Informaticore/SuperPower/SuperPower-uC/components/BATTERY_CELL_HOLDER_18650_SMT_1042/keystone-PN1042.STEP

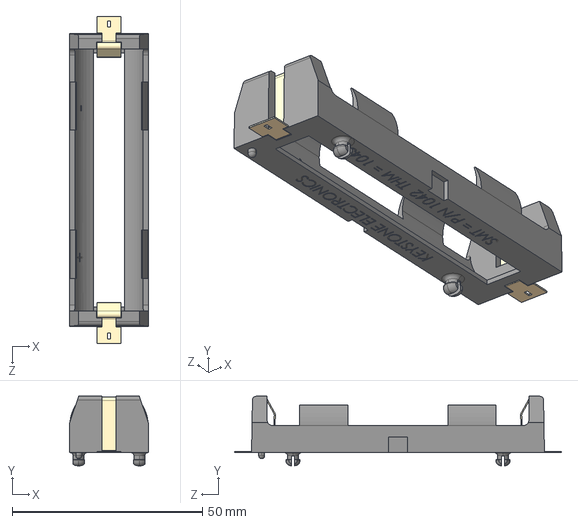
[picture p1: CAD file, 2020-12-24]
SuperPower-uC/components/BATTERY_CELL_HOLDER_18650_SMT_1042/keystone-PN1042.STEP
20.7 x 18.3 x 86.0 mm
