Informaticore/SuperPower/SuperPower-uC/components/JST_ZH_S2B_THRU/S2B-ZR.STEP

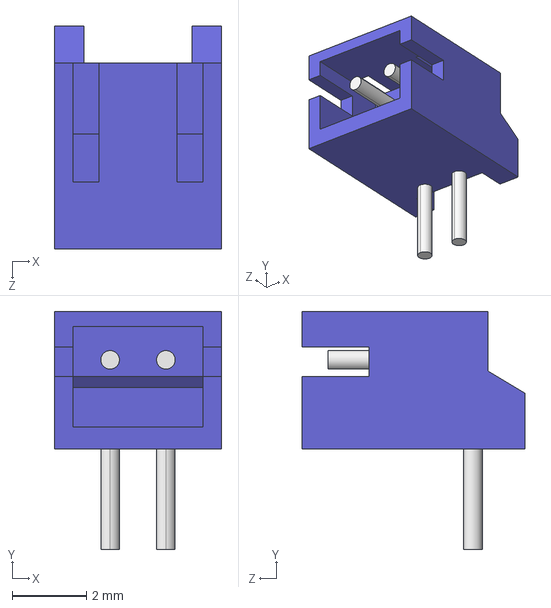
[picture p2: CAD file, 2020-12-23]
SuperPower-uC/components/JST_ZH_S2B_THRU/S2B-ZR.STEP
4.50 x 6.40 x 6.00 mm
