Informaticore/SuperPower/SuperPower-uC/components/RV-3028-C7/RV-3028-C7_MWNN.step

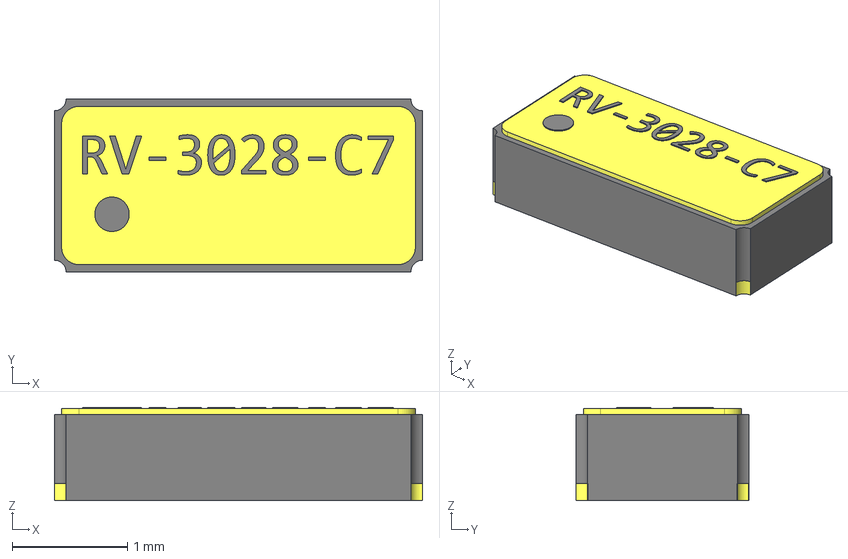
[picture p3: CAD file, 2020-12-26]
SuperPower-uC/components/RV-3028-C7/RV-3028-C7_MWNN.step
3.20 x 1.50 x 0.81 mm
Gold_Cover
Ext_pin_1
Ext_pins_org
Ext_pins_clone
Ext_pins_clone_2
Inner_pin_org
Inner_pin_clone_180deg
Inner_pin_clone_0_9mm
Inner_pin_clone_0_95mm
