Informaticore/SuperPower/SuperPower-uC/original/3D_Box/3D_Box_save_07.FCStd

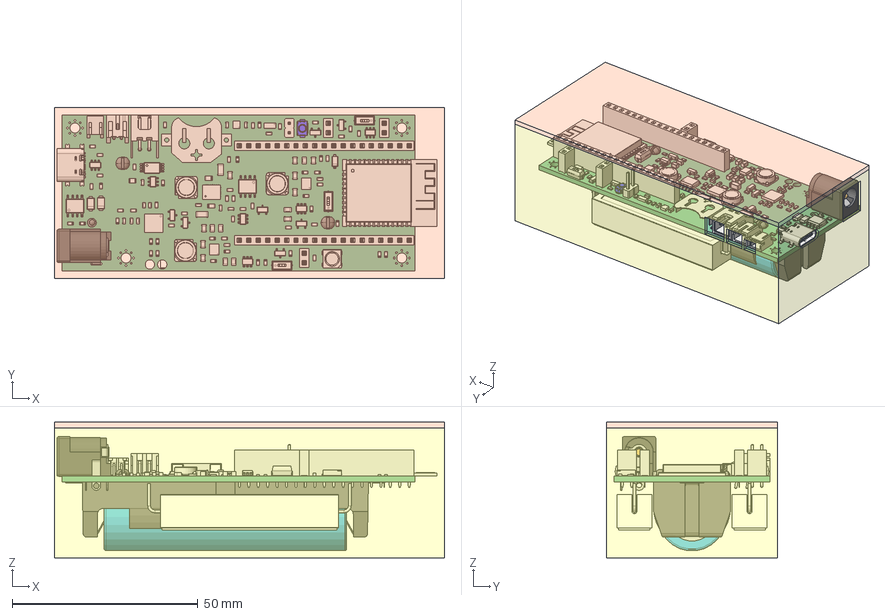
[picture p4: CAD file, 2020-12-30]
SuperPower-uC/original/3D_Box/3D_Box_save_07.FCStd
105.0 x 46.0 x 36.5 mm
Body_cover
enveloppe001
Rondelle_+
Pin
Pin_clone
Mark
Mark_Line2
Pin001
Pin_clone001
Mark001
Mark_Line003
Pcb_bade001
C13_C_0603_1608Metric_5FE1E67D
Q13_SOT_23_6_5FE1FFE7
C13_C_0603_1608Metric_5FE1E67D001
C13_C_0603_1608Metric_5FE1E67D002
R28_R_0603_1608Metric_5FE1E7A0
Q1_TSSOP_8_44x3mm_P065mm_5FE238C001
J6_PinHeader_1x02_P254mm_Vertical_5FE1EB83
U8_WSON_6_1EP_2x2mm_P065mm_EP1x16mm_5FE68943
U5_RV-4162-C7_5FE68809
SW1_SKRKAE_5FE20513
U2_USB4110-GF-A_5FE2434D
R28_R_0603_1608Metric_5FE1E7A001
R28_R_0603_1608Metric_5FE1E7A002
C13_C_0603_1608Metric_5FE1E67D003
Q13_SOT_23_6_5FE1FFE008
R1_R_0805_2012Metric_5FE21CBB008
C7_C_1206_3216Metric_5FE083F012
C13_C_0603_1608Metric_5FE1E67D004
C13_C_0603_1608Metric_5FE1E67D005
R28_R_0603_1608Metric_5FE1E7A003
R28_R_0603_1608Metric_5FE1E7A004
R28_R_0603_1608Metric_5FE1E7A005
R28_R_0603_1608Metric_5FE1E7A006
R28_R_0603_1608Metric_5FE1E7A007
Q9_SOT_23_5FE1FFAA020
Q9_SOT_23_5FE1FFAA021
C13_C_0603_1608Metric_5FE1E67D006
C13_C_0603_1608Metric_5FE1E67D007
D3_LED_SK6812_PLCC4_50x50mm_P32mm_5FE1FD084
R28_R_0603_1608Metric_5FE1E7A008
D4_D_SOD_123_5FE1DF018
C13_C_0603_1608Metric_5FE1E67D008
D1_D_PowerDI_123_5FE332B3
J5_JST_S2B_XH_A_5FE092EF001
Q9_SOT_23_5FE1FFAA022
Q9_SOT_23_5FE1FFAA023
Q9_SOT_23_5FE1FFAA024
R1_R_0805_2012Metric_5FE21CBB009
R1_R_0805_2012Metric_5FE21CBB010
R28_R_0603_1608Metric_5FE1E7A009
R28_R_0603_1608Metric_5FE1E7A010
U4_QFN_28_1EP_4x5mm_P05mm_EP265x365mm_5FDDAC5B001
U6_QFN-28-1EP_5x5mm_Pitch0.5mm_5FE1E4A004
U7_ESP32-WROOM-32_5FE1FEBA001
Q9_SOT_23_5FE1FFAA025
U10_RNR11_5FD85147
U10_RNR11_5FD85148
R28_R_0603_1608Metric_5FE1E7A011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
