Informaticore/SuperPower/SuperPower-uC/original/3D_Box/3D_Box_save_05.FCStd

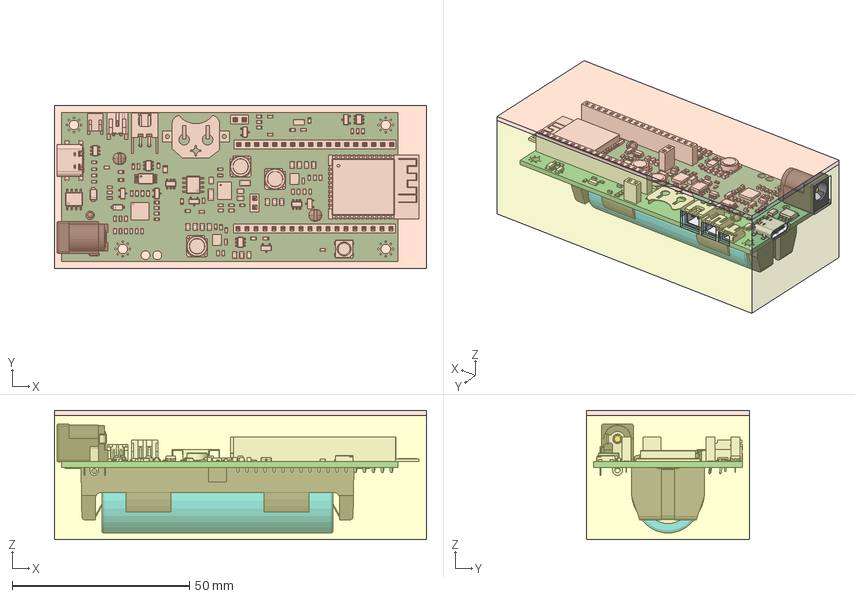
[picture p6: CAD file, 2020-12-24]
SuperPower-uC/original/3D_Box/3D_Box_save_05.FCStd
105.0 x 46.0 x 36.5 mm
Body_cover
enveloppe001
Rondelle_+
Pcb_bade
U2_USB4110-GF-A_5FE2434D001
R2_R_0603_1608Metric_5FE23902
R2_R_0603_1608Metric_5FE24000
Q1_TSSOP_8_44x3mm_P065mm_5FE238C0
C1_C_0603_1608Metric_5FE23887
U1_SOT_23_6_5FE2384D
R1_R_0805_2012Metric_5FE21CBB
C7_C_1206_3216Metric_5FE083F7
C1_C_0603_1608Metric_5FE23919
C1_C_0603_1608Metric_5FE23920
R2_R_0603_1608Metric_5FE24001
R2_R_0603_1608Metric_5FE24002
R2_R_0603_1608Metric_5FE24003
R2_R_0603_1608Metric_5FE24004
R2_R_0603_1608Metric_5FE24005
U1_SOT_23_6_5FE2384D010
Q9_SOT_23_5FE1FFAA
Q9_SOT_23_5FE1FFAA014
C1_C_0603_1608Metric_5FE23921
C1_C_0603_1608Metric_5FE23922
D3_LED_SK6812_PLCC4_50x50mm_P32mm_5FE1FD83
R2_R_0603_1608Metric_5FE24006
D4_D_SOD_123_5FE1DF17
C1_C_0603_1608Metric_5FE23923
D1_D_PowerDI_123_5FE332B004
J5_JST_S2B_XH_A_5FE092EF
J8_PinSocket_1x18_P254mm_Vertical_5FE1FDD2
Q9_SOT_23_5FE1FFAA015
Q9_SOT_23_5FE1FFAA016
Q9_SOT_23_5FE1FFAA017
R1_R_0805_2012Metric_5FE21CBB006
R1_R_0805_2012Metric_5FE21CBB007
R2_R_0603_1608Metric_5FE24007
R2_R_0603_1608Metric_5FE24008
U4_QFN_28_1EP_4x5mm_P05mm_EP265x365mm_5FDDAC5B
U6_QFN-28-1EP_5x5mm_Pitch0.5mm_5FE1E4A3
U7_ESP32-WROOM-32_5FE1FEBA
Q9_SOT_23_5FE1FFAA018
U10_RNR11_5FD85142
U10_RNR11_5FD85146
U5_RV-4162-C7_5FE1E3D3
R2_R_0603_1608Metric_5FE24009
R2_R_0603_1608Metric_5FE24010
R2_R_0603_1608Metric_5FE24011
R2_R_0603_1608Metric_5FE24012
R2_R_0603_1608Metric_5FE24013
R2_R_0603_1608Metric_5FE24014
R2_R_0603_1608Metric_5FE24015
R2_R_0603_1608Metric_5FE24016
R2_R_0603_1608Metric_5FE24017
R2_R_0603_1608Metric_5FE24018
R2_R_0603_1608Metric_5FE24019
R2_R_0603_1608Metric_5FE24020
J6_PinSocket_1x02_P254mm_Vertical_5FE1EB83
C25_C_0805_2012Metric_5FE224A7
C1_C_0603_1608Metric_5FE23924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
