Informaticore/SuperPower/SuperPower-uC/original/3D_Box/3D_Box_save_04.FCStd

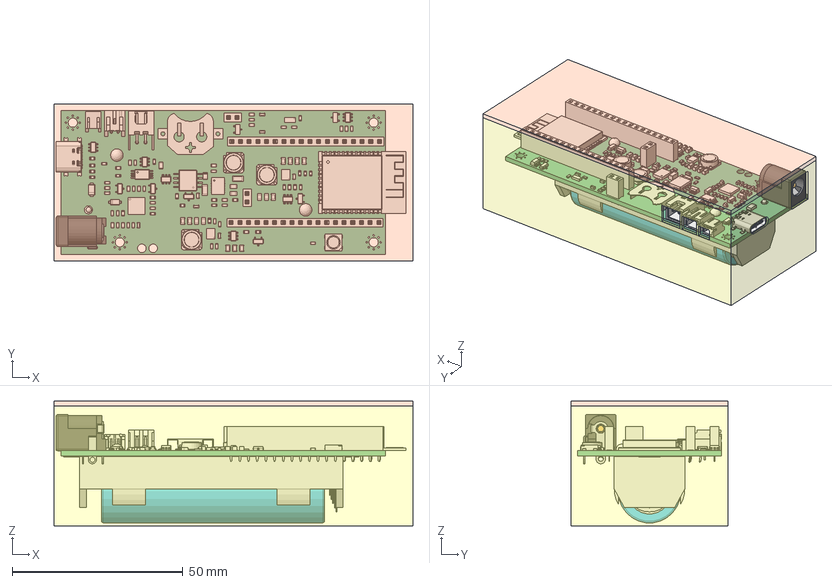
[picture p7: CAD file, 2020-12-23]
SuperPower-uC/original/3D_Box/3D_Box_save_04.FCStd
105.0 x 46.0 x 36.5 mm
Body_cover
Pcb_bade001
U2_USB4110-GF-A_5FE2434D
R2_R_0603_1608Metric_5FE23951
R2_R_0603_1608Metric_5FE23952
Q1_TSSOP_8_44x3mm_P065mm_5FE238C001
C1_C_0603_1608Metric_5FE23903
U1_SOT_23_6_5FE2384D005
R1_R_0805_2012Metric_5FE21CBB003
C7_C_1206_3216Metric_5FE083F009
C1_C_0603_1608Metric_5FE23904
C1_C_0603_1608Metric_5FE23905
R2_R_0603_1608Metric_5FE23953
R2_R_0603_1608Metric_5FE23954
R2_R_0603_1608Metric_5FE23955
R2_R_0603_1608Metric_5FE23956
R2_R_0603_1608Metric_5FE23957
U1_SOT_23_6_5FE2384D006
Q9_SOT_23_5FE1FFAA007
Q9_SOT_23_5FE1FFAA008
C1_C_0603_1608Metric_5FE23906
C1_C_0603_1608Metric_5FE23907
D3_LED_SK6812_PLCC4_50x50mm_P32mm_5FE1FD084
R2_R_0603_1608Metric_5FE23958
D4_D_SOD_123_5FE1DF018
C1_C_0603_1608Metric_5FE23908
D1_D_PowerDI_123_5FE332B3
J5_JST_S2B_XH_A_5FE092EF001
J8_PinSocket_1x18_P254mm_Vertical_5FE1FDD004
Q9_SOT_23_5FE1FFAA009
Q9_SOT_23_5FE1FFAA010
Q9_SOT_23_5FE1FFAA011
R1_R_0805_2012Metric_5FE21CBB004
R1_R_0805_2012Metric_5FE21CBB005
R2_R_0603_1608Metric_5FE23959
R2_R_0603_1608Metric_5FE23960
U4_QFN_28_1EP_4x5mm_P05mm_EP265x365mm_5FDDAC5B001
U6_QFN-28-1EP_5x5mm_Pitch0.5mm_5FE1E4A004
U7_ESP32-WROOM-32_5FE1FEBA001
Q9_SOT_23_5FE1FFAA012
U10_RNR11_5FD85144
U10_RNR11_5FD85145
U5_RV-4162-C7_5FE1E3D004
R2_R_0603_1608Metric_5FE23961
R2_R_0603_1608Metric_5FE23962
R2_R_0603_1608Metric_5FE23963
R2_R_0603_1608Metric_5FE23964
R2_R_0603_1608Metric_5FE23965
R2_R_0603_1608Metric_5FE23966
R2_R_0603_1608Metric_5FE23967
R2_R_0603_1608Metric_5FE23968
R2_R_0603_1608Metric_5FE23969
R2_R_0603_1608Metric_5FE23970
R2_R_0603_1608Metric_5FE23971
R2_R_0603_1608Metric_5FE23972
J6_PinSocket_1x02_P254mm_Vertical_5FE1EB085
C25_C_0805_2012Metric_5FE224A022
C1_C_0603_1608Metric_5FE23909
C25_C_0805_2012Metric_5FE224A023
C25_C_0805_2012Metric_5FE224A024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
