Informaticore/SuperPower/SuperPower-uC/original/3D_Box/3D_Box_save_01.FCStd

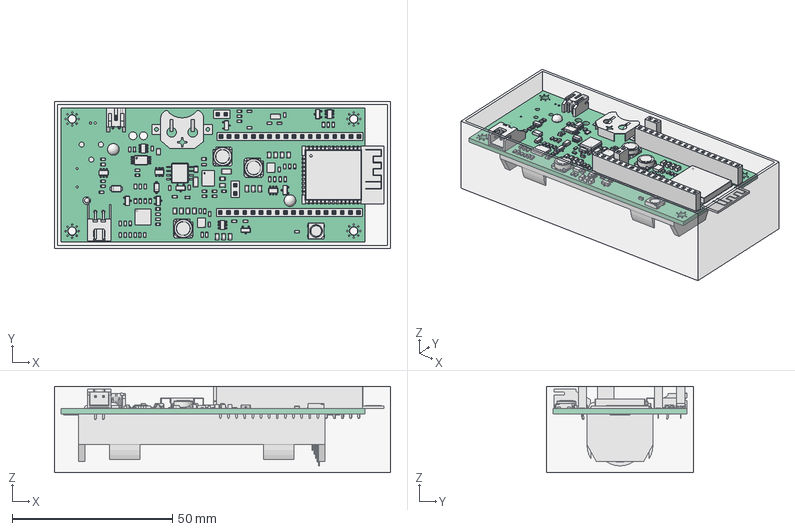
[picture p8: CAD file, 2020-12-22]
SuperPower-uC/original/3D_Box/3D_Box_save_01.FCStd
105.0 x 46.0 x 27.0 mm
Pcb_bade
R2_R_0603_1608Metric_5FE23902
R2_R_0603_1608Metric_5FE23903
Q1_TSSOP_8_44x3mm_P065mm_5FE238C0
C1_C_0603_1608Metric_5FE23887
U1_SOT_23_6_5FE2384D
R1_R_0805_2012Metric_5FE21CBB
C7_C_1206_3216Metric_5FE083F7
U3_TSOP_6_165x305mm_P095mm_5FE243A0
R2_R_0603_1608Metric_5FE23904
C1_C_0603_1608Metric_5FE23888
C1_C_0603_1608Metric_5FE23889
R2_R_0603_1608Metric_5FE23905
R2_R_0603_1608Metric_5FE23906
R2_R_0603_1608Metric_5FE23907
R2_R_0603_1608Metric_5FE23908
R2_R_0603_1608Metric_5FE23909
U1_SOT_23_6_5FE2384D001
Q9_SOT_23_5FE1FFAA
Q9_SOT_23_5FE1FFAA001
C1_C_0603_1608Metric_5FE23890
C1_C_0603_1608Metric_5FE23891
D3_LED_SK6812_PLCC4_50x50mm_P32mm_5FE1FD83
R2_R_0603_1608Metric_5FE23910
D4_D_SOD_123_5FE1DF17
C1_C_0603_1608Metric_5FE23892
D1_D_PowerDI_123_5FE2442D
J5_JST_S2B_XH_A_5FE092EF
J8_PinSocket_1x18_P254mm_Vertical_5FE1FDD2
Q9_SOT_23_5FE1FFAA002
Q9_SOT_23_5FE1FFAA003
Q9_SOT_23_5FE1FFAA004
R1_R_0805_2012Metric_5FE21CBB001
R1_R_0805_2012Metric_5FE21CBB002
R2_R_0603_1608Metric_5FE23911
R2_R_0603_1608Metric_5FE23912
U4_QFN_28_1EP_4x5mm_P05mm_EP265x365mm_5FDDAC5B
U6_QFN-28-1EP_5x5mm_Pitch0.5mm_5FE1E4A3
U7_ESP32-WROOM-32_5FE1FEBA
Q9_SOT_23_5FE1FFAA005
U10_RNR11_5FD85142
U10_RNR11_5FD85143
U5_RV-4162-C7_5FE1E3D3
R2_R_0603_1608Metric_5FE23913
R2_R_0603_1608Metric_5FE23914
R2_R_0603_1608Metric_5FE23915
R2_R_0603_1608Metric_5FE23916
R2_R_0603_1608Metric_5FE23917
R2_R_0603_1608Metric_5FE23918
R2_R_0603_1608Metric_5FE23919
R2_R_0603_1608Metric_5FE23920
R2_R_0603_1608Metric_5FE23921
R2_R_0603_1608Metric_5FE23922
R2_R_0603_1608Metric_5FE23923
R2_R_0603_1608Metric_5FE23924
J6_PinSocket_1x02_P254mm_Vertical_5FE1EB83
C25_C_0805_2012Metric_5FE224A7
C1_C_0603_1608Metric_5FE23893
C25_C_0805_2012Metric_5FE224A008
C25_C_0805_2012Metric_5FE224A009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
