Informaticore/SuperPower/SuperPower-uC/components/BarrelJack_Wuerth_6941xx301002/694106301002 (rev1).step

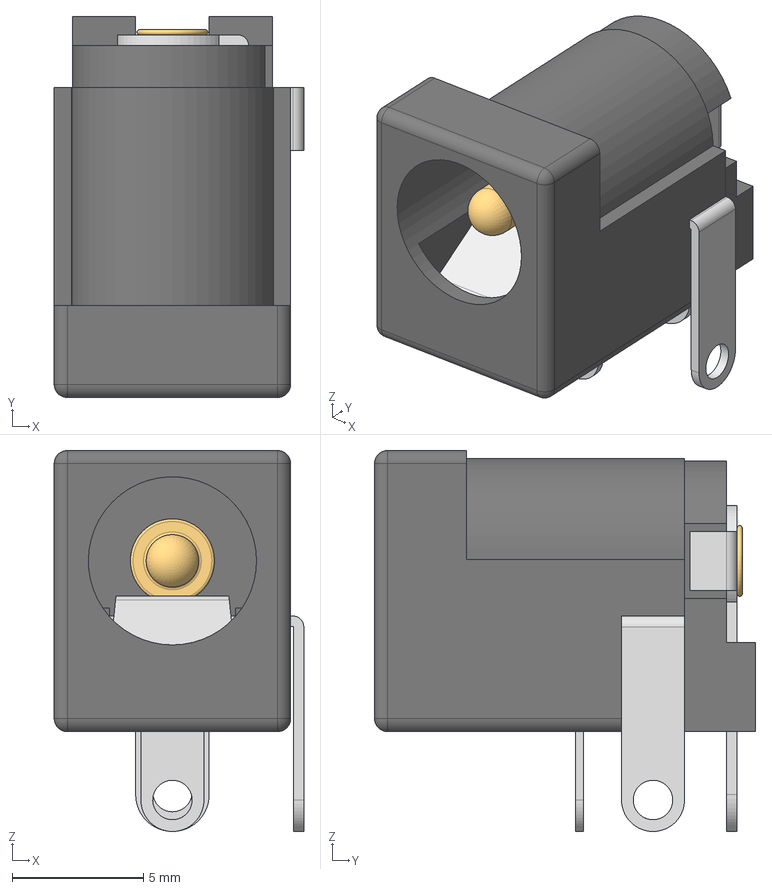
[picture p9: CAD file, 2020-12-23]
SuperPower-uC/components/BarrelJack_Wuerth_6941xx301002/694106301002 (rev1).step
9.50 x 14.5 x 14.5 mm
6941xx301002
694106301002_PinContact
6941xx301002_Back
6941xx301002_PinContact2
6941xx301002_PinLame
6941xx301002_PinBis
