Informaticore/SuperPower/(list of files, cad)

Other CAD files:
SuperPower-uC/original/3D_Box/3D_Box.FCStd
SuperPower-uC/original/3D_Box/3D_Box_save_03.FCStd
SuperPower-uC/original/3D_Box/3D_Box_save_02.FCStd
