Informaticore/SuperPower/(threads)

Thread 24 (2020-10-11):

PCB default config without soldering

wassfila, 2020-10-11:
In the current status and PR https://github.com/Informaticore/SuperPower/pull/23 the user of the PCB would have to solder the 1 cell jumper before he can use the board.
As 95% of users might be using a single cell, suggestion is to make it the default

- the pcb should be operational for 1 cell out of the box
- undersoldering an soldering 0 ohm and bridges should only be required if a different config 2 or more cells are required

wassfila, 2020-10-11:
@MantaRayDeeJay I see two 0 ohm resistors, but is it possible to configure that only one of them is mounted by default ?
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

MantaRayDeeJay, 2020-10-11:
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
Please see "Add default 1 cell setting"commit

wassfila, 2020-10-11:
I can't see such commit, maybe you did not push it yet ? when you mention a commit, you can copy and paste the hash number and github will create an automatic link, very convenient when we talk about commits

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

c1945163cbadd14c11eed62c1720836f3af2eb88

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

MantaRayDeeJay, 2020-10-11:
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
As you can see in the table, the 2 pins (CELLS0 and CELLS1) should be tied to INTVcc to select "1 CELL"

wassfila, 2020-10-11:
issue already fixed with c915a490a23e91a1651dea954c5cda66bbbb2c43

Closed 2020-10-11.

Thread 27 (2020-10-11):

generate svg schematics for low cost variant

wassfila, 2020-10-11:
The low cost variant might be our best seller to feed R&D of the Original (Premium) variant, so we might want to update the github action to generate the svg schematics separately.
@Informaticore I remember you mentioned that, but I can't see that in any branch, so we can use this as a reminder and close it simply if it was already done, then maybe link where.

current master 6b6abbf4b22ff191eef2cfc5b6933118083df25d
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

Informaticore, 2020-11-09:
this was done last week and can be found in the .generated folder

wassfila, 2020-11-09:
@Informaticore is it now generated automatically on each action ? Or do we abandon the idea of automatic generation and update them manually when we need ? That would be ok for me, and if so, the ticket can stay closed.

Informaticore, 2020-11-10:
back-pushing of the generated files is causing too much trouble. The action is still running on push (if *.sch files changed) and PRs so we can always find the files in the artifacts to push them manually.

Closed 2020-11-09.

Thread 30 (2020-10-12):

document lowcost BOM

wassfila, 2020-10-12:

Tobi3566, 2020-10-12:
[SuperPower-uC-KiCad.txt](https://github.com/Informaticore/SuperPower/files/5366430/SuperPower-uC-KiCad.txt)

Tobi3566, 2020-10-12:
[SuperPower-uC-KiCad (2).txt](https://github.com/Informaticore/SuperPower/files/5366446/SuperPower-uC-KiCad.2.txt)

wassfila, 2020-10-12:
fixed with d1f85f1

wassfila, 2020-10-12:
@Tobi3566
https://superpower.readthedocs.io/en/latest/uc/low/overview.html
should be ok as a first draft
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

Closed 2020-10-12.

Thread 31 (2020-10-12):

generate BOM csv for documentation

wassfila, 2020-10-12:
the generated documentation can include CSV files as they are, so can take advantage to keep documenting the latest version.

Informaticore, 2020-10-13:
for that generation we might clean up the components first in KiCad. You remember that table I was talking about once? @wassfila

wassfila, 2020-10-13:
>
>
> for that generation we might clean up the components first in KiCad. You remember that table I was talking about once? @wassfila

right, for the component folder I have #28 I'll comment about it there

Thread 39 (2020-10-20):

original mcu review

wassfila, 2020-10-20:
Reviewer : Raspi Team : Seth K
here are a couple easy steps that can make it easier to read.
First, I'd recommend using SOME net labels on page
1.  This would reduce the wiring clutter, and make the more important signals stand out.
2. I would recommend adding expanding each circuit block so the circuits have more room to "breathe", and adding a text label under each block to indicate what they are/do.

2010019970909, 2020-10-27:
https://github.com/Informaticore/SuperPower/pull/48/commits/82af7b3988ff3aaf0015fdd3ca698e6752f5edce, adds comments to describe the function of most of the blocks.

wassfila, 2020-11-16:
Feedback from team meeting review notes from @Informaticore
Meeting Notes:
# Schematic review to da max
    - freeze schematics after last change for regulators
    - create ticket and reviews/findings from everybody there
    - https://github.com/Informaticore/SuperPower/issues/39
    - check requirements against the current schematics if they are met

# Components annotation for BOM
- use same unit for components (100nF vs. 0.1uF)
- deciding for footprints
    - Resistor: 0603
    - avoid BGA
    - capacitor X7R rating
        - <10uF 0603
        - '>10uF 0805
    - wisley choose inductors
- set the foot prints
- swap components by multible different values to reduce component number
- one person should do that cleanup/setting

ToDo:
- put LED indicator for Power on VIN on the charger sheet

wassfila, 2020-11-16:
- check again if the +5V reg should not get a Mosfet instead of driving the Enable pin
uA current won tbd.

Thread 42 (2020-10-25):

Team meeting 25/10/2020

wassfila, 2020-10-25:
Agenda :
* Solve the confusing situation of the Fuel Gauge
* Charging Status LED
* (feature/mcu) Look closer on #36 and seek assistance to bring it to master
* (feature/regulator_rtc) have a common review and maybe merge #41
* state the open points that prevent the original variant from starting routing
* think of a routing strategy, how to split the routing job

wassfila, 2020-10-25:
## Fuel Gauge general discussion
- generally voltage only, not very reliable as it does not map in percentage of remaining capacity
- that's why a simple compare at one level Full/Empty would be enough
- the LTC has a function to measure the internal resistance => aging of the battery details in the datasheet
- requirement # 10 rejected at a time when LTC was not planned, then LTC functionality took over.
- The advantage of a fuel gauge is to show a measure independent from the uC
- if the uC gets involved then all options become easy, not even an LED compare would be needed, but still one LED compare can be kept to make it more reliable
- two extremes simplest and best
   - simplest, it's not about simplicity, it's more about reliability
   - it's more important to have configurable options
   - most advanced fuel gauge, RGB Led (while charging only) / ePaper monitor (low power)

## Charging Status LED

=> TODO #44 simulation ongoing @2010019970909 with test of LED battery full status (local work could be put on a file on the repo)

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

## MCU PR
- #36 blocked with #43 help wanted, error on github PR job not seen on local ERC (file missing)

Closed 2020-10-25.

Thread 43 (2020-10-25):

MCU branch - ERC error

wassfila, 2020-10-25:
Yep, any help is welcome.
I've tried to track the changes that have still to be done [here](https://github.com/Informaticore/SuperPower/projects/4).

For the DRC, on the MCU sheet, there is only one relative to the MCU (one pin of the pins header not connected, which is related to the replication of the low cost version which I did not do yet). The rest of the DRC errors is on other sheets. Also there was two remarks on #39 (one about using net label (I suppose for the voltages, etc., but they are global one in KiCad, so we have to be in sync).

_Originally posted by @2010019970909 in https://github.com/Informaticore/SuperPower/pull/41#issuecomment-716181248_

wassfila, 2020-10-25:
could not figure out what the error was in the team meeting #42
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

2010019970909, 2020-10-25:
Might be related to https://github.com/nerdyscout/kicad-exports/issues/8. I'll let @Informaticore, if he has the time, get in touch with Nerdyscout to investigate the issue (the warning might be causing the issue though).

2010019970909, 2020-10-29:
Closed by #47, the path separator used by the `update_sym-lib-table.py` script was causing the GitHub action to fail (since UNIX path are used in the KiCad export GitHub action).

Closed 2020-10-29.

Thread 44 (2020-10-25):

charge indicators measurement and user interface

wassfila, 2020-10-25:
one comparator to be used to switch an LED on for status
- monitoring only when USB is connected
- when the current is below 25 mA it will turn the LED on
- to use a comparator (OpAmp) designed to be a comparator and not a generic OpAmp
- impact of sense resistor on the LTC4162 might affect it if its ground is lifted up, so might consider to measure from the top instead of from the ground.

## LED colors
- red LED to show the USB / Panel power
- blue led for charging
be aware of high voltage that might not fit when using blue white and true green LEDs

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

wassfila, 2020-11-04:
@2010019970909 this might completely change the scope of this ticket, would you prefer to keep this one and we create a new one for the RGB LED ? Or is it ok to rename it like I did ?

2010019970909, 2020-11-04:
@wassfila, maybe it's better to rename this ticket, "charge indicators (measurement and user interface)". IDK.

wassfila, 2020-11-04:
@2010019970909 I did rename it like that. But actually the measurement part is going to fly away if we use the user LED and LTC readings.

wassfila, 2020-11-13:
fixed by #52
the duplicated charge measure external to ltc won't be needed.

Closed 2020-11-13.

Thread 46 (2020-10-26):

member review of the low cost variant

wassfila, 2020-10-26:
### LowCost SuperPower-UC Board review

Author: Seth K
Date: 2020/10/25
commit: 6ffc7bc

Fix:
* Fix the DRC errors.  There's only 2 of them with the same two parts.  The only excuse for submitting a board with DRC errors is if there is a bug with the DRC itself, and you've submitted a bug report to KiCAD.
* Go over the silkscreen to clean up the positions and orientations of the labels.  You can easily drop to 0.8x0.8x0.153 (per JLC's minimums). While I understand it's a very tight board, you can absolutely get 90+% of the silkscreens legible and useful.
    * Examples: R16 is completely lost under D4. U5 should not be under the IC.
* Remove the random stubs at X133.35 Y102.362 and X140.716 Y100.584.

You really should Fix:
* Having vias in pad is a complication that many PCB vendors try to avoid.  This results in solder theiving, which ends up causing no-connects as the assembly step.
    * If you are getting the board with the HASL finish (as the cheap option @JLC), that will fill the vias with solder.  However, HASL is not recommended for pick and place.  I have done stencil, solder-paste, and toaster oven assembly on HASL boards, and it works, but is not consistent.
    * ENIG, which is recommended for pick and place, will not fill the vias unless you specify it, and that will cost extra money. MOST, if not all, of the vias within the pad have room to move them out into soldermasked board.  (JLC doesn't cap/tent vias: https://easyeda.com/forum/topic/Via-inside-pad-9c8f0f0bf1c748f28a067b1052ea5603)
* Change the header to header distance to a round number.  It should be either 25.4mm (1 inch), 25mm, or 26mm.  While 25.146mm is close enough to 25.4mm that the tolerance of the header's holes will allow for mounting to a breadboard, it just doesn't look professional to have this be arbitrarily choosen.
    * Expanding on this:  When using standard parts, you should either stick to the standard or make it VERY clear that you are NOT adhering to the standard.  You used 0.1"(2.54mm) pitch headers, so you should place them an even multiple of 0.1"(2.54mm) apart.

Consider fixing:
* The minimum via size is 0.6mm x 0.3mm.  This will help significantly with your crowding problem.  Also, while I'm impressed you were able to get this routed with 0.25mm tracks, you could easily drop to 0.2mm or 0.175mm and still be very easily manufacturable cheaply.
* There is a good amount of room in the upper left and lower left corners of the board.  Is there a reason you didn't place components there to give yourself a little more space?
* You should review the PCB for any instances where a nudge of tracks will reduce the number of vias and/or reduce the amount of perforation in the ground plane.  (I put this under "consider" because it is not wrong, but changing it would ease manufacturability. )
    * Example: The VCHARGE & 3v3FTDI nets.   If you move the via at x111.887 y108.21 Northward, you can remove 2 of the vias on VCHARGE.
    * Example: The GPIO0 net near J7. Instead of going East with two vias, you could easily circle around by going West first.

Comments:
* I'm concerned about the location of C19. This is right next to the antenna, and is the reset signal.  If the RF energy couples in just the right way, it'll potentially cause random restarts. You could easily move C19 to next to Q4.
* You should really try to avoid isolated ground pours whenever possible. I see the vias and tracks tieing the planes together, however, if that can be avoided by using judicious placement of vias, it's all the better.
* I have heard from PCB manufacturing experts that acute angles should be avoided, as they trap acid and can form a latent failure.  U1, pad 1 is a good example of this.
    * I say "I have heard" because I have not personally experienced that failure, but it is a common one that is mentioned.
* In the future, for arbitrarily defined expansion headers, such as J5 & J6, consider changing the schematic to accomodate the layout.  For the most part, you did this, but GPIO0 could have easily been moved from pin 1 to pin 13 of J5 to make routing easier, and for it to match the ESP pinout.
* For the sake of anyone making a case for this, please round the board dimensions to a reasonable number.   84.0mm x 29.0mm is no more expensive to make than 83.556mm x 28.194mm
    * Having random numbers like that just makes things difficult for anyone trying to use it.
* If possible, avoid direct bridges of pins for gull-wing packages, as these can be intepreted as solder bridges by the assembly house.
    * Examples: U3 pins 1&2, U9 pins 1&2

wassfila, 2020-10-26:
fixed with #45

Closed 2020-10-26.

Thread 56 (2020-11-16):

PCB routing Process and first step

wassfila, 2020-11-16:
notes from @Informaticore Team meeting minutes :
# How are we doing the routing?
- try the <click> but then route by hand
- only one branch is used!
- we need a volunteer (most knowledge about kicad?) to start routing. Volunteer decides the time and shares its screen (24h before)
- start routing together with placing components (share ideas)

2010019970909, 2020-11-17:
@wassfila,

- we can use Freeroute (https://youtu.be/BQpAmRV79FM [FR], https://freerouting.org/freerouting/using-with-kicad) for the routing, but it's better to first route the sensitive tracks;
- OK for one branch, but we can make different branches locally to play with the routing tool;
- personally I know how to use it but I'm not an expert (saturday afternoon is a good moment to route some tracks, but first we have to place the components and to define the mechanical dimensions, the rest is usual business xD).

wassfila, 2020-11-18:
@2010019970909 I created this ticket out of the meeting minutes, but anyway we agreed to start this all together, we might have to agree on discord when to have this meeting. if no suggestion comes up, it might end up being next Sunday 19h during the Team meeting.
@Informaticore or should we plan it separately ?
From what I understood, the routing is not that of a big deal that requires automatic routing, but maybe some routing assistance features might make the manual routing smarter and faster.
For branching, as long as it's local, it of course does not matter, only one routing branch will be merged back so to say which will be the commonly used one.
Also we might have to coordinate the routing with regards to the review cleanup, on what should come first. Given that any cleanup in the schematics result in reworking the routing as well, it might be that we shift routing till the "clean freeze" of the schematics :)

Thread 57 (2020-11-16):

SuperPower-uC Original Review

sethkaz, 2020-11-16:
commit: 7201a1d
Schematic review only.

Fix:
- I might be wrong on this, but I believe the power ORing circuit might not work as intended.
  - I believe the diodes should be either Zener diodes or should be put in backwards.  The intention is probably zener diodes.  However, one must balance the turn-on of the FET with the max voltage being backfed into the lower power supply.
- There are several capacitors of identical value that have slightly different footprints.  C707&C717, C709&C71, C713&C718.
  - This may seem like a trivial distinction, especially as the difference is on the distance between the pads, but keeping parts consistent will help with making this PCB easier to build and assemble.
- What is the purpose of R4/R5 having both JP1/JP2?  It seems that JP1/JP2 satisfies the need for tying the CELLS0/1 signals to their appropriate nodes.
- The reference designators should follow a consistent pattern.  It should be incremental from 1, such as on the charger page, or it should include the page number, like on the regulator page.
  - When a design has both, it just ends up being confusing and asking for people to say "what happened here??".  Both systems have their pros and cons, so just pick one and stick with it.
- The feedback dividers should have one of their resistors be a re-used part.  There is no reason for R701, R703, R706, and R707 to be unique parts.  130k and 150k could easily be changed to 100k, and the top resistor could be changed to another value.  This would eliminate 2 unique parts.
- For U701 and U702, re-draw the part to fix pins 12/13 and 7/8.  Showing them as "1213" and "78" makes it look like it's a 1213-pin part, rather than the 15 pin part it is.  (Yes, I realize that the package designer at TI got quite creative with the merged, u-shaped pins in the package, but that's not a reason to confuse the reader of your schematic.)
  - Option 1: Use KiCAD's hidden pins to stack pins 13 and 8.  https://kicad.org/libraries/klc/S4.3/  (Just be cautious of the Power Input and Power Output pin designation, as that will make connections you weren't expecting.)
  - Option 2: Show individual pins for 7, 8, 12, and 13.  This adds a little bit of clutter, but does capture all the connections. (Not my preferred solution here.)
  - While you are changing this, you should move FB over to the right hand side, near VOUT, as those two pins are directly related.
- Use consistent units: C11 (0.1uF) and C1 (100nF).  (My personal preference is to not use nF, but it's not a rigid rule. )
- For R20 & R21, change the values to reduce the unique part count by 1.  The 22k can be changed to 10k, and the 47 can be something around 21.3k (=47k/22k)

You really should Fix:
- Label R12 or Q4A as DNP.  (As a global comment: make the DNP parts clear that they are intended to be DNP.)
- Consider removing R13.
- The feedback dividers should look like typical feedback dividers in the totem-pole orientation.
- Rotate the VIN labels on pins U701.1213 and U703.6 so that they connect with the end of the wire.  This will eliminate the hanging wire squares that are visible.  This also applies to U701.1.
- For R24 and R25: instead of trying to stuff the value into the body of the symbol, it is perfectly acceptable to place the reference designator and value on the wire (in the same sense as the net label) immediately before and after the resistor (or inductor or capacitor).
- On the MCU module page, VIN is not used on that page. I would recommend removing the wire, and the hierarchical label, along with the wire on the top sheet.
- I believe the note "Permanent Power Jumper" should be on the charging module block.  This is the circuit R14/Q4A, correct?

Consider fixing:
- The label for the PWR_FLAG being visible doesn't really add anything to the schematic.  Consider hiding those to clean up the schematics.
- Consider changing R1 to be 470 Ohm.  This will eliminate a unique part on the BOM, and is within the suggested range on the datasheet.
- Consider changing R19 an R22 to be 470 Ohm.  This will eliminate another unique part.  The LEDs will still be very much functional with the lower current.
- Consider hiding the value field for JP1/JP2.  They don't add any clarity to the schematic, but do add clutter.
- R11 and R7 can probably be unified to a single value to eliminate a unique part.
- I would recommend re-orienting Q701 to highlight the fact that the voltage is being sourced by 3v3_RTC.  At the moment, it is not clear what it's purpose is.
- If possible, consider changing Q5 and Q6 to be NMOS instead of an NPN.  This would help reduce part count, and possibly simplify your design.  Alternatively, maybe consider using logic gates to generate the signals needed.  I haven't worked it out, but it looks like 2 XOR gates might get you the same functionality.
- For nets CHREN, CHR0, and CHR1, you should remove the wire and net label, and leave the no connection flag.  If the pin is not being connected to anything else, then labelling it like that is not necessary and potentially confusing.

Comments:
- On the regulator page, the package sizes of the capacitors are shown on the sheet.  I would recommend making that a meta-data field of the component, rather than an unattached text.  This would help keep the data together. It would also be easier to move, copy, modify, or hide.
- Thank you for including a truth table for the autoflash/reset circuit.
- My repeated mentioning of reducing the unique part count is to drive the cost of this board down.  Every unique part is one more reel and feeder that the assembly house needs to put on their pick n place, which means more labor hours ($$$) and more opportunities for mistakes ($$$).
- It's a nice touch to include all the math and calculations on the schematic.  It's a bit overkill for me, as I would have put those in the sphinx docs, but still the effort to document is appreciated.

MantaRayDeeJay, 2020-11-16:
What is the purpose of R4/R5 having both JP1/JP2? It seems that JP1/JP2 satisfies the need for tying the CELLS0/1 signals to their appropriate nodes.
**ANSWER** : Using only 1 cell is the default setting option.
- In case where the board is bought with components soldered, R4 and R5 should be populated. (No need to add hand solder on "solder-jumpers") -> Just Buy it and use it !
- In case where the user (advanced user) want to use more than 1 cell, the "solder-jumpers" can be soldered manually with the right settings (Removing R4/R5 will be also needed in case the board is bought with components soldered)

MantaRayDeeJay, 2020-11-16:
Consider removing R13.
**Answer** : The divider bridge formed by R10 and R13 initially protect the gate of MOSFET from OVER VOLTAGE.
As the LTC4162L allow 35V on Input, often gate voltage for 30V P-MOSFETs is limited to +/-20V.
But to fully use the onboard components (LDO and Buck-Boost regulators), +15V is the max allowed voltage, so the R13 can not be populated.

MantaRayDeeJay, 2020-11-16:
Consider changing R1 to be 470 Ohm. This will eliminate a unique part on the BOM, and is within the suggested range on the datasheet.
**Answer** : The 9101C chip datasheet tells that we can use a resistor value from 330 to 470 ohms.
So we can use 330, 390 or 470 ohms as standard values.
So, you're right, we can reduce resistors values range !
https://www.diodes.com/assets/Datasheets/AP9101C.pdf
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

MantaRayDeeJay, 2020-11-17:
R11 and R7 can probably be unified to a single value to eliminate a unique part.
**Answer** : I'm not agree.
- R7 is used to limit the overall input current.
- R11 is used to limit only the battery charging current.
So, their functions are not the same !

dr-stefan-krank, 2020-11-17:
Some answers to questions regarding RTC and regulators:

> commit: [7201a1d](https://github.com/Informaticore/SuperPower/commit/7201a1da604b783479e6c57aa4eaa46b97019563)
>     * The feedback dividers should have one of their resistors be a re-used part.  There is no reason for R701, R703, R706, and R707 to be unique parts.  130k and 150k could easily be changed to 100k, and the top resistor could be changed to another value.  This would eliminate 2 unique parts.

These resistor values are taken from the datasheet to select the desired voltage. They may be replaced like you said to get component use down.
This is something that should be done when we optimize the BOM and see what other values we have at hand.

>     * For U701 and U702, re-draw the part to fix pins 12/13 and 7/8.  Showing them as "1213" and "78" makes it look like it's a 1213-pin part, rather than the 15 pin part it is.  (Yes, I realize that the package designer at TI got quite creative with the merged, u-shaped pins in the package, but that's not a reason to confuse the reader of your schematic.)

These symbols were directly taken from SnapEDA. Yes, they should be reworked. They are ugly.

>     * On the regulator page, the package sizes of the capacitors are shown on the sheet.  I would recommend making that a meta-data field of the component, rather than an unattached text.  This would help keep the data together. It would also be easier to move, copy, modify, or hide.

These sizes are written down there, just because the datasheet listed them there like that even with these exact values. That can be removed later, but I wanted to make sure that this isn't accidentally overseen and poorly chosen.
Especially if some values are the same, but the package is different. I'm no expert enough to decide to chose other packages than the datasheet tells us to use.

> ### RTC
>
>     * what exactly is the purpose of the J601 in the RTC sheet? Should we add a button here?

Like the annotation says, there should be an exposed pin. This will manually wake up the board if something external happens.
Can be a button, a reed switch for a window or any other type that creates a rising or falling edge.
We could add a button on the board, which would be quiet handy, but we definitely need to expose a pin.

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

Should be removed as soon as the BOM is fixed. As explained above, these sizes may be important as they are listed in the datasheet. It's just a very visible reminder.

sethkaz, 2020-11-17:
So just to clear up a choice in words:  The phrase "power oring" is not powering, nor power o-ring.  It is "Power OR-ing".  As in, it is selecting power from A **OR** B.

2010019970909, 2020-11-17:
> So just to clear up a choice in words: The phrase "power oring" is not powering, nor power o-ring. It is "Power OR-ing". As in, it is selecting power from A **OR** B.

Good catch. I don't know why I wrote oring... BTW, for the VIN on the MCU sheet, at one moment I was thinking about adding it to the main pins headers of the board. It's often done on other boards, but it can be removed if it's not pertinent. Personnally for the IO2, 13 and 15, I'd connect them to the pin headers too. They are still IO and it's easier for the troubleshooting to have them mapped too.

MantaRayDeeJay, 2020-11-17:
I believe the note "Permanent Power Jumper" should be on the charging module block. This is the circuit R14/Q4A, correct?
**Answer** : Do you mean about R12/Q4A ?
If yes, there is 2 "populated" options :
- Without "optimize quiescent current in shipmode" option : populate ONLY R12 (Default settings)
- With the Option : populate R10, R13, Q4A and Q3
Rem. : Even if the option is populated, adding R12 will disable the feature and is NON DESTRUCTIVE (MOSFET By-Pass)

MantaRayDeeJay, 2020-11-18:
**Charger** - 390k R13 should be after Q3 and not in between Q4 and Q3!
**Answer** : Could you tell me why ?

Informaticore, 2020-11-18:
> **Charger** - 390k R13 should be after Q3 and not in between Q4 and Q3!
> **Answer** : Could you tell me why ?

because it is like this in the schematics. I might be wrong.
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

MantaRayDeeJay, 2020-11-18:
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

Yes, this is slightly different.
As said in the datasheet, "**RA  and  RB  form  a  voltage  divider  preventing full gate drive to MP1.**" so the position of R13 has no importance when Q3 is drived : the gate is fully protected in both case.
I have changed it because I think it might be an error :
If the voltage on RB (R13) is too high (more than 2.5V - VGSth) the MOSFET can't be drived.
The voltage on RB (R13) is about 0.28 Vout (Vgs max if often +/- 20V for 30V MOSFET as example)
So even with only 5V on Vin, this is not sure to work properly with the "datasheet schematic".

MantaRayDeeJay, 2020-11-19:
what is that resistor for R3 when the battery has an internal protection?
**Answer** : There is 2 "populate" ways :
- With Battery protection feature : U1, Q1, R1 and C1 populated
- Without Battery protection feature : R3 populated
Rem. : If Battery protection feature is populated, populating R3 is also possible (Q1 By-pass).
But U1 will always stay active. (always 3µA quiescent current)

MantaRayDeeJay, 2020-11-19:
SMBALTER LED Resistor has no value
**Answer** : This is normal, the schematic was not finished.
The R value depends of the Forward voltage and Efficiency of the LED which will be used.
Rem. : Forward Voltage depends of the "color" of the LED
I would recommend to use a 0805/0603 package and a high efficiency to have the lower LED current.

MantaRayDeeJay, 2020-11-19:
solder jumper part looks quite complicated do to its symbols, maybe we choose a "easier to read" symbol which creates less track-crossings
**Answer** : In my opinion, this is not specialy complicated.
What would you suggest ?

MantaRayDeeJay, 2020-11-19:
move all images in this sheet to ReadTheDocs on a separate page to explain the settings a bit more detailed. Image do not fit in the svg or pdf format because they do not scale.
**Answer** : Having images in ReadTheDocs is of course welcomed !
Currently, KiCAD is limited and doesn't allow inserting of SVG images in schematic sheets.
Concerning Formulas, I think this is also a good thing leaving them on shematic sheets. I will recommend only to change "Formula images" by some text.
Concerning other images (like curves), we can leave them only on ReadTheDocs

MantaRayDeeJay, 2020-11-19:
SMBALERT might be usefull for the MCU as well, at least add a TP to it. We might wake the MCU when SMBALTER interrupts. (Default is no alert, so it is programmable)
**Answer** : I also think that it would be a nice feature.

MantaRayDeeJay, 2020-11-19:
Battery protection sheet, charger sheet and the charger i/O sheet having an connector for the battery. On the Charger I/O it is marked wrong with V_CHARGE as an input. This can be removed but it uses the S2B-PH-SM4-TB(LF)(SN) connector as a label which is commonly used for batteries, we should keep it. I also would remove the connector from the charger sheet and only keep it on the battery protection sheet. We might then just add 2 pads as well for soldering a battery if wanted.
**Answer** : Don't mix all connector features :
- Battery Protection sheet : The Battery connector is for external battery usage (other than the 18650 embeded)
- Charger sheet : The battery connector is used to power external device/board directly from the battery voltage.
- I/O sheet : It seems there is no battery connector.

Rem. : It was previously talked on the chat !

MantaRayDeeJay, 2020-11-19:
The charger I/O sheet should only get solder pads + barrel jack and no connector or screw-terminal. (maybe screw-terminal but they are big and ugly and expensive)
**Answer** : I'm not agree.
- Screw-terminal is a common connector used on lot of boards. In my opinion, this is a usefull option.
If you have a look on Aliexpress, you will see that this kind of connectors are cheap.
- In case where you'd rather like to use only solder pads, just don't populate Screw-terminal and use their solder pads instead.
This solution will allow to save space on the board and therefore, you can remove the extra solder pads (represented by the JST PH connector)

Informaticore, 2020-11-20:
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

okay - gotcha! I looked at it again and I see it now, thanks

Informaticore, 2020-11-20:
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

of course - if we it is just a formula we should leave it but as text. and curves and things go into ReadTheDocs. We can also have a whole section for calculations and formulars on RTD which we can link in the schematics (just hard to type because I think there are no links :) )

Informaticore, 2020-11-20:
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

the JST PH connector is the one we should use for the battery. If you check Adafruit you can get lots of batteries there with that connector. The I/O sheet has this connector but it was /is a mistake by me. The idea was to have this for the battery.

I might mix things up so I try to clean it:
INPUT: Solar
HOW: via barrel-jack or screw-terminal (unpopulated) which also gives us pads

INPUT/OUTPUT: Battery
HOW: on-board holder, solder-pads, JST PH.

Would this answer the confusion?

Informaticore, 2020-11-20:
> Charger sheet : The battery connector is used to power external device/board directly from the battery voltage.
this I don't get.

MantaRayDeeJay, 2020-11-21:
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

**Answer**
I think that we shouldn't use the same connector for both "External Battery connector" (Battery Input) and "Battery Power connector" (battery Output). They are not on the same nets.
Therefore, to avoid confusion, I'd rather like to use one XH (2,5mm picth - 3A max) and one PH (2,00mm pitch - 2A max).
XH should be used for the "Battery Input" in case we want to charge with higher current.

Thread 58 (2020-11-21):

Review Actions

Informaticore, 2020-11-21:
- [ ] fix footprints of capacitors C707&C717, C709&C71, C713&C718. The footprint is identical but different in the pads
- [ ] redraw U701 and U702 symbol showing 1213 and 78
- [ ] make units consistent either 0.1uF or 100nF. Let us go with uF
- [ ] For R20 & R21, change the values to reduce the unique part count by 1. The 22k can be changed to 10k, and the 47 can be something around 21.3k (=47k/22k)
- [ ] Use DNP for unpopulated parts
- [ ] Mark R12 as DNP and leave Q4A (Default setup)
- [ ] Make R1 470 Ohm
- [ ] Change values of  R701, R703, R706, and R707 to match the desired voltage but also fit other resistor values like 100k
- [ ] Add a switch to J601 as addition to wake up on press (suggestion: SKRKAEE020 but debatable)
- [ ] Remove 0805 and 0603 text comments from the schematic and choose the footprint
- [ ] finish the SMBALTERT LED circuit with LED and resistor value
- [ ] Move images from the Charger sheet into a ReadTheDocs Page, only keep formulas as text
- [ ] Attach SMBALERT track to the MCU
- [ ] Remove VIN from MCU sheet including the tracks because it is unused
- [ ] Mark screw-terminal on charger IO sheet as DNP and remove JST connector (misplaced)
- [ ]

last step to not loose references from review:
- [ ] re-anotate the whole project for the sake of consistent designators

2010019970909, 2020-12-12:
Here is a LTSpice simulation for the ORing.

[ORing.zip](https://github.com/Informaticore/SuperPower/files/5683676/ORing.zip)

Thread 60 (2020-12-02):

Power Switching Topology Choice

MantaRayDeeJay, 2020-12-02:
  | BLARG | InformatiCore | ManWithNoName | Tobi | Vincent | Wassfila
-- | -- | -- | -- | -- | -- | --
  |   |   |   |   |   |  
**+3.3V_MCU** |   |   |   |   |   |  
High Side Switching | [ ] | [ ] | [ ] | [ ] | [ ] | [ ]
Low Side   Switching | [ ] | [ ] | [ ] | [ ] | [ ] | [ ]
TPS_Enable_Pin | [ ] | [ ] | [ ] | [ ] | [ ] | [ ]  
  |   |   |   |   |   |  
**+3.3V** |   |   |   |   |   |  
High Side Switching | [ ] | [ ] | [ ] | [ ] | [ ] | [ ]
Low Side   Switching | [ ] | [ ] | [ ] | [ ] | [ ] | [ ]
  |   |   |   |   |   |  
**+5V** |   |   |   |   |   |  
High Side Switching | [ ] | [ ] | [ ] | [ ] | [ ] | [ ]
Low Side   Switching | [ ] | [ ] | [ ] | [ ] | [ ] | [ ]
TPS_Enable_Pin | [ ] | [ ] | [ ] | [ ] | [ ] | [ ]

MantaRayDeeJay, 2020-12-02:
Thanks for each team member to make a choice of which topology you would like to have for each "Power switching" stage.

Thread 63 (2020-12-07):

LowCost Rev1 issues

Tobi3566, 2020-12-07:
1. Missing pullup for io Expander (fixed)
2. Missing pullup for GPIO0 Pin (fixed)
3. Missing pullup for EN Pin (fixed)
4. Cap on Enable pin to small (fixed)
5. power cut to ESP while FTDI is still powered via USB caused it to bootup in Flash mode (fixed by adding diode in series to only enable the FTDI to pull down EN pin)
6. wrong pin mapping of FTDI crystal (fixed)
7. wrong pinmaping of auto reset Transistors (fixed)
8. Interrupt line not on the pin header for easy override (fixed)
9. missing bypass cap for IO expander (fixed)
10. unstable IO expander I2C communication due to Vlogic being supplied by VBat (fixed by connecting Expander supplies to V_I2C

Thread 64 (2020-12-13):

Team meeting 13/12/2020

Informaticore, 2020-12-13:
**Main task: find the right mosfets!**

- [x] Power ORing circuit needs a change. Replacing the VBUS MOSFET with a diode
- [x] Move connectors on the bottom side
- [x] Choose the right inductor for the voltage regulators
- [x] add diode to the auto-reset circuit IO0 track (like in low cost version)
- [x] Checkout maximum limits for board sizes
- [x] Create and add footprint for the 3 ways solder jumper.

... and continue laying out the board

**Still open:**
- [x] discuss ORing circuity (@2010019970909 and Seth)
- [x]  re-anotate the whole project for the sake of consistent designators
- [x] Replace N-Channel at RTC with P-Channel (see image below) and move the MOSFET to the Regulator sheet @dr-stefan-krank
- [x] Research Dual-Channel CMOS component (if we find a good one we go for high side switching on 5V and 3.3V-MCU, if not we keep 5V low-side switching)

**_Optional:_**
- [x] +3.3V Switching change to high side switching (instead of low side currently)

Closed 2021-01-31.

Thread 65 (2020-12-20):

Team Meeting 20/12/2020

Informaticore, 2020-12-20:
Topics to discuss:
- Board dimensions and appearence (90x90 or raspberry pi size?)
- connectors and pads - which are needed? how accessible should they be?
- ~Remove screw terminals and replace with pads + holes?~
- MOSFETS!
- Requirements check

**Board Dimensions:**
- smallest possible: 87mm x 27mm (narrow version)
- smallest square: 87mm x 87mm
- raspberry-pi size 85mm x 56mm
- Arduino (Uno) PinOut (for shields) + 18650 extension of ~2cm <- **prefered**
- Arduino (Uno) PinOut (for shields) + 18350 Battery Holder on the bottom side <- **also liked**
- ESP32 DevKit PinOut + 18650 or 18350 Battery Holder

**Connectors**
- nothing to add here - all good

**MOSFET**
- nothing too add here - all good

**ToDo's:**
- [x] Add 3x 3v3 and 3x 5V Pins and GND Pins to the PinOut (3v3_MCU and 3v3 (switchable)) (_if the space allows it_)
- [x] From @MantaRayDeeJay: Add backup battery pads for RTC (_Coin or SuperCap_) (**needs changes on the schematics**)
-> need more thoughts and use-cases

Closed 2021-01-31.

Thread 67 (2021-01-10):

Team Meeting 10/01/2020

Informaticore, 2021-01-10:
**Topics:**
Decision:
- We agreed with going with the squared and stacked solution!
- 4 Layers for the Boards

**Board Names?**
Suggestion:
SuperPower-LETO for the Raspi (RPi)
SuperPower-APOLLO for the ESP (Original)
SuperPower-ARTEMIS for the ESP (LowCost)

**Next steps/Actions:**
- [x] Layout/Schematic: Remove 0R of VBUS (it is not useful to remove it at this position)
- [x] Layout: Fix the 3D models
- [x] Research: Check ESP32 Antenna Top and Bottom
- [x] Layout: USB-C Connector to the left side (also external input)
- [x] Schematic: Exchange RGB-LED with smaller Version

**Documentation**
- [x] Move to Hugo instead of ReadTheDocs (to have Markdown)
- [x] Check file generation for LowCost Version

Closed 2021-01-31.

Thread 68 (2021-01-17):

Team Meeting 17/01/2020

Informaticore, 2021-01-17:
@wassfila created a nice new **_hugo_** documenation for the SuperPower Project!
Link: https://superpower.github.io/
Repo: https://github.com/SuperPower/hugo_website

**Action Points:**
- [ ] Ask Andreas about to move the repos to the GitHub Organisation
- [ ] splitting the repos?
- [ ] Add GND(s) Pin to the interface connector

Thread 69 (2021-01-19):

Review Layout

Informaticore, 2021-01-19:
- [ ] add version/revision and date

MantaRayDeeJay, 2021-01-22:
I think that we should improve the GND pins position on J9/J10

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

The goal is to do +3.3V and GND pins close together and to add a " virtual shield" between I2C signals and USB signals

MantaRayDeeJay, 2021-01-22:
The copper layer 2 should be defined as a "Power Plane"
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

MantaRayDeeJay, 2021-01-22:
The Layer 2 is defined as a power plane and should be a TRUE power plane without any tracks.
The GND plane must clean to avoid any "loop" effect.

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

On the ESP board, move the track on layer 3 or layer 4.
On the Charger board, move the track on layer 4.

MantaRayDeeJay, 2021-01-22:
I can see only one pin connected to the "+3.3V_i2c" plane shape, what is the utility of this plane shape ?

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

MantaRayDeeJay, 2021-01-22:
3v3_I2C plane shape could be optimized. Only draw the area you need. It will increase insulation distance between other power plane shapes.

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

MantaRayDeeJay, 2021-01-22:
SilkScreen Layer : Max input Voltage can't be +20V (TPS63070 only accept 16V max).
PS : I have specified +15V max on the schematic.

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

Informaticore, 2021-01-23:
>  Add Silkscreen RefDes for Connectors

@MantaRayDeeJay they all got naming and description do you really need the ref?

>  Add more "Net Label" to improve the routing process (especially near the DC-DC converters/charger)

I don't understand what you mean with "Net Label", what are you referring to?

>Add one 2pts connector/pads for each ouput voltage (+3.3V, +3.3V_MCU and +5V). We need to have the possibility to power sensors, external boards, display, etc. (even if the ESP board is connected)

I will try to add some

MantaRayDeeJay, 2021-01-23:
@Informaticore

    Add more "Net Label" to improve the routing process (especially near the DC-DC converters/charger)

I don't understand what you mean with "Net Label", what are you referring to?

**ANSWER**
An example below (with one of the 2 DC-DC converters).
PS : It should be great to do it for the 2 DC-DC converters and for the LTC4162L charger chip
Then, I could continue the review easily on these 3 critical layouts.

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

Informaticore, 2021-01-23:
okay - got it

MantaRayDeeJay, 2021-01-23:
@Informaticore

    Add Silkscreen RefDes for Connectors

@MantaRayDeeJay they all got naming and description do you really need the ref?

**ANSWER**
I think mainly about 2pts connectors because there are 4 on the board.
To avoid any confusion, I should recommend to add it. (sometimes, text on silkscreen and text on schematic are not always synchronized). The Ref. Des. stay the only unique ID for each component.

PS : Always think about newbies. (it should be easy for everyone !!!)

MantaRayDeeJay, 2021-01-23:
@Informaticore

ESP32 module :
The recommanded layout use 12 vias on the Power GND Pad, I can see only one on the board.
I think, vias should be added at the footprint level.

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

Informaticore, 2021-01-23:
@MantaRayDeeJay do you know how to add vias in a footprint?

MantaRayDeeJay, 2021-01-24:
**ESP32 Module : Antenna Clearance**

I can see that the recommanded clearances are not fully respected.
It should be 15mm min distance (not only 5mm)

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

⁣
⁣
Possible solution : Use a Mouting Hole without any copper shape and avoid the usage of metal screw (Nylon should be good).

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

Informaticore, 2021-01-24:
We can go back to M2 holes but then we have to go everywhere, also on the charger board.

MantaRayDeeJay, 2021-01-24:
@Informaticore

We can go back to M2 holes but then we have to go everywhere, also on the charger board.

**ANSWER**
You don't have enough space on the board to use M2.5 Mtg holes (currently 2.5mm hole diameter without enough clearance space from the edge of the board)
Therefore, we haven't any other choice than using M2 holes (2.2mm hole diameter)

PS : We can keep Mtg holes with copper shape for those on the opposite side of the ESP Module Antenna on the charger board.

Informaticore, 2021-01-24:
I made all of them M2.2 (no pad) for consistency

MantaRayDeeJay, 2021-01-24:
@Informaticore

@MantaRayDeeJay do you know how to add vias in a footprint?

I didn't try it yet.
I think that you could have a look on the footprint used by the LTC4162L to see how it is build (there are vias)

**UPDATE**

Adding Vias in a footprint is the same way as adding padstacks. (all vias pin numbers must be the same as the EPAD padstack)

I have updated the ESP32 module footprint : Epad 3x3 matrix + vias  (as recommanded on the datasheet)
[ESP32-WROOM-32_EPAD_3x3_ThermalVias.zip](https://github.com/Informaticore/SuperPower/files/5862602/ESP32-WROOM-32_EPAD_3x3_ThermalVias.zip)

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

MantaRayDeeJay, 2021-01-24:
@Informaticore

**Schematic - Max USB Current settings**

Currently, the max current setting for the USB port is 3A.
But the reverse protection diode can sink only 2A max.
Moreover, Max current used by the board is limited to 500mA (LTC4162 settings) to be compliant with USB2 devices.

I think we should limit the USB current to 1.5A for safety.

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

MantaRayDeeJay, 2021-01-24:
@Informaticore

**CP2102N : QFN28 footprint**

I think you should use the "ThermalVias" Version (I think, only 1 via is not enough)
PS : Via hole diameters are defined with 0.2mm. You should redefine them to 0.3mm. (idem as Sethkaz Review)

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

MantaRayDeeJay, 2021-01-26:
@Informaticore

Power Vdd net is not well routed. (track width = 0.25mm)
You should use wider copper tracks and copper shape

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

MantaRayDeeJay, 2021-01-26:
@Informaticore

Same thing for the "net-(Q3-Pad1)" between MOSFET Q3 and Rsense R13

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

MantaRayDeeJay, 2021-01-26:
@Informaticore

LTC4162-L Layout

Apply the recommended rules from the Datasheet (p. 35)

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

DC2038A Demo Board Layout

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

MantaRayDeeJay, 2021-01-27:
@Informaticore

**Vdd Plane shape issue**

On layer 4, the "Vdd" plane shape is inner the "GND" plane shape.
As you can see, the "GND" plane is generated first and then the "Vdd" plane is not well generated.

The trick is to increase the "Zone Priority Level" feature on the **Filled Zone** properties dialog box.

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

Informaticore, 2021-01-27:
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

this will be a bigger refactor and change. I will try to do that.

Informaticore, 2021-01-27:
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

I know, I forgot about it but strangely the DRC was not warning about it!! That is very bad, it shows 0 issues. Do you see DRC complaining?

MantaRayDeeJay, 2021-01-27:
@Informaticore

    Vdd Plane shape issue

    On layer 4, the "Vdd" plane shape is inner the "GND" plane shape.
    As you can see, the "GND" plane is generated first and then the "Vdd" plane is not well generated.

    The trick is to increase the "Zone Priority Level" feature on the Filled Zone properties dialog box.

I know, I forgot about it but strangely the DRC was not warning about it!! That is very bad, it shows 0 issues. Do you see DRC complaining?

**ANSWER**

YES, I can see it !!!

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
⁣
By setting "Zone Priority Level" = 1, DRC is clean as you can see below !!!
⁣
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

MantaRayDeeJay, 2021-01-28:
@Informaticore

    LTC4162-L Layout

    Apply the recommended rules from the Datasheet (p. 35)

this will be a bigger refactor and change. I will try to do that.

**NEXT**

This is better but it can be improved.

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

Informaticore, 2021-01-29:
@MantaRayDeeJay I applied more changes but I am not 100% about you drawings, please describe a bit more what else should be changed. But I think I got most of it, please check. All the thick traces are thick now, should be good.

MantaRayDeeJay, 2021-01-29:
@Informaticore

@MantaRayDeeJay I applied more changes but I am not 100% about you drawings, please describe a bit more what else should be changed. But I think I got most of it, please check. All the thick traces are thick now, should be good.

**ANSWER**
I would like VBat Capacitor (C6) and Rsense (R20) as the recommanded layout used on the DEMO Board.
By moving J2, you should have enough place to do it.
Moreover, you should keep the RTC chip and Battery protection circuitry enough away from the inductor. (You can also add a shield GND plane around the Inductorr with some Vias on the layer Top)

MantaRayDeeJay, 2021-01-29:
@Informaticore

**TPS63070 - Footprint Issue**

1) Pin 12-13 copper area is wrong for the soldermask and solderpast layer.

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

2) The footprint is SMT !!! (not THT)

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

3) You must delete any global solderpast and soldermask layers on all copper pads. (The footprint countains custom solderpast and soldermask pads)
-> Check all copper pads
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

MantaRayDeeJay, 2021-01-30:
@Informaticore

**TPS63070 : Apply the recommanded Layout**
1) Place C1 and C4 as Figure 51 (C19 & C24 for U9 and C21 & C25 for U10)
2) Route L1 and L2 nets as Figure 51 (use vias under pads)
3) Add a gnd shield around the inductor on the top layer as Figure 51

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

MantaRayDeeJay, 2021-01-30:
@Informaticore

Maybe I found critical signals too near the LTC4162-L inductor without GND shield on top layer.
I recommand to keep away critical signal near inductors.
In this case, it concerns 2 MOSFET gate pin (Q1 and Q5).

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

MantaRayDeeJay, 2021-02-01:
@Informaticore

LTC4162-L : Separate Inductor GND Shield from other GND Tracks.

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

MantaRayDeeJay, 2021-02-01:
@Informaticore

TPS63070 : Separate Inductor GND Shield from other GND Tracks.

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

MantaRayDeeJay, 2021-02-01:
@Informaticore

TPS63070 : Optimize Inductor Power shapes against EMI noise : Remove some extra shape area to improve clearance from others nets.

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

MantaRayDeeJay, 2021-02-01:
@Informaticore

TPS63070 : Remove "Artifact Tracks" near capacitors

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

MantaRayDeeJay, 2021-02-01:
@Informaticore

**USB Data Lines** : Use a differential pair by following the recommanded rules on the link below.

High Speed USB Design Guidelines
http://ww1.microchip.com/downloads/en/AppNotes/doc7633.pdf

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

Thread 70 (2021-01-20):

Review of layout in feature/layouting_square_stack_mirko (5714cf4)

sethkaz, 2021-01-20:
Need to fix:

- [x] 1.      Fix the DRC issues around the mousebite vias.  You will have to work with the board house as to how they would like to proceed with this.  KiCAD allows 0.41mm diameter vias with a 0.4mm hole, so maybe use that to clear up the DRC.
- [x] 2.	Fix the DRC issues around the TPS63070 components.  If you make that hidden trace on pin 10 to be 0.2mm wide instead of 0.25mm, it will clear up the error.
- [x] 3.	There is a sliver of ground plane that will act like an antenna directly adjacent to J7.13 on the F.Cu layer.  Adjust the trace from J7.14 to fix this.
- [x] 4.	On page 4 of the schematic, J5.1 is connected to +BATT.  However, in actuality, it is connected to the local VBAT label.  I would HIGHLY recommend changing the label on J5.1 to VBAT, because one shouldn’t need to go to 2 other schematic pages to find that two differently named nets are connected.
- [x] 5.	The trace between R20.2 and L1.2 is thin and could be widened.
- [ ] 6.	The lack of reference designators will be very troublesome for people who will need to debug this.  Or for people who want to probe the board to see how it works.  We’ve had long discussions about this, but my recommendation doesn’t change:  If you have a silkscreen layer and have the space, you absolutely should include that info in there.
- [x] 7.	Pin R9.2: There is no reason for this trace to the plane to be as long or as circuitous as it is.  Please shorten it to a simple drop to plane trace.
- [x] 8.	Pin R22.1: There is a via in pad here.  It doesn’t serve a purpose, so remove it.  While you’re at it, I would recommend removing the other extra via in the immediate vicinity as well.
- [x] 9.	U10 and L3 have some very small traces between them.  The converter is taking 3.6A gulps each time it switches, so those thin traces will start to really make an impact.  I would recommend rotating U10 counterclockwise by 90 degrees to make the routing easier.
- [x] 10.	Same goes for U9 and L2.
- [x] 11.	The traces around L1 (both pins) are very small.  The narrow traces add to the ESR of the inductor, and reduce the efficiency.  The calculation for the inductor current is 45mv/68mOhm = ~660mA.  It’s not a large current like the 3.6A for U10 and U9, but it’s enough to warrant widening the traces or even better, using copper pours.
- [x] 12.	Consider reducing the thermal clearance on the planes.  This will generally improve the coverage in the board.  They are currently set to 0.508mm, which is a very large clearance.  You could easily change this to 0.2mm without any impact on manufacturing.  This is especially a problem under U4 where the vias have only a few spokes, and the center vias are isolated.  This is bad practice for thermal design.

Should fix:

- [x] 13.	Pin U4.18:  There’s no reason for there to be 2 vias directly adjacent to this.  Pull the traces on In1.Cu and B.Cu from a single via.
- [x] 14.	Change the silkscreen note from “FTDI” to “USB-Serial”, or something similar.  This is because the chip being used is not made by FTDI, so it could lead to some confusion
- [x] 15.	I’d recommend widening the plane on In2.Cu around the pin J10.10.  There is only one thermal spoke for this pin, and it can easily be fixed.
- [x] 16.	Pin Q1.6&7, consider merging this to a single GND via, or at least move them a little further away from each other.  The PCB vendor might complain about the drill hits being too close together.
- [x] 17.	The USB C connector might need to be nudged a little away from the edge of the board (moving to the right or East).  This is because the PCB vendor has rules about the distance between copper features and the board edge.  A typical number I’ve seen 0.020” (or 0.508mm).
- [x] 18.	The same can be said for the copper of the mounting holes.
- [x] 19.	Pad C28.1 has a via very close to it, and could contribute to solder thieving.

Consider fixing:

- [ ] 20.	The hole size for the LTC4162 is 0.2mm.  This might be a challenge to build at some board houses for a reasonable cost.
- [ ] 21.	The Silkscreen notes on the right hand board have a thickness of 0.125mm.  This might be a problem for some PCB vendors to make.  I would recommend staying above 0.006” (0.153mm).
- [x] 22.	At Q1.3&2, consider moving the trace bridge out from this location.  While it is easier to route, it can cause false alarms in the automated inspection steps.  As in, it looks like a short between pins, and the AOI steps are looking for that.
- [x] 23.	I would recommend ditching the GND plane on the F.Cu layer completely. It is only being used in 2 places, and both of those can be replaced with a trace very quickly.  The disadvantage is that it adds a lot of copper features that could be places that act as antennas or worse.
- [ ] 24.	The connector for J4 is pretty fine in pitch.  If the intention is for people to manually solder something in, maybe consider moving up to a 2mm pitch?  There is plenty of room to do so.
- [x] 25.	The trace between R36.1 and Q8.3 can be re-routed to not use the ground plane.  One easy method is to move R36 next to Q7, and rotate it 180.  The track could then go above Q7 for easy routing.

Notes/Comments:

- [x] 26.	I like the silkscreen outlines of the functional areas.  That helps explain what’s happening on the PCB, and mitigates my silkscreen comment above.
- [x] 27.	So I noticed that the connector J3 has 2 large holes with no electrical contacts, and 2 surface mount pins.  I’m assuming this is a method of strain-relief for the wires, correct?   If so, as the hole size is not very critical, I would recommend reducing the number of unique hole sizes by increasing this diameter to match the mounting hole size.  As in 2.2mm -> 2.5mm.

Informaticore, 2021-01-20:
Is there a global setting for thermal clearance?

Informaticore, 2021-01-20:
15.: widening the plane was not helping to get more thermal spokes. The clearence of the Pads next to it is to large. should I reduce the clearance for that component? Is there an global setting? Or should I leave it then?

sethkaz, 2021-01-20:
> 15.: widening the plane was not helping to get more thermal spokes. The clearence of the Pads next to it is to large. should I reduce the clearance for that component? Is there an global setting? Or should I leave it then?

To edit them globally, use the button in the lower left of the Copper Zone Properties window.

I was able to get it wrap around and make 3 connections.  You just have to play with all 4 numbers a bit.

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

Informaticore, 2021-01-20:
> 20. The hole size for the LTC4162 is 0.2mm. This might be a challenge to build at some board houses for a reasonable cost.
what hole size would be better?

sethkaz, 2021-01-21:
It really depends on the vendor.  PCBway's "cheapest" hole size is 0.3mm.

Informaticore, 2021-01-21:
>18. The same can be said for the copper of the mounting holes.

Moving them will create a big mess - I will try it out and see if the manufacturer says anything against it :)

Informaticore, 2021-01-21:
>  20. The hole size for the LTC4162 is 0.2mm. This might be a challenge to build at some board houses for a reasonable cost.

I mark that as done - I will leave it as is because that is the original footprint

Informaticore, 2021-01-21:
Closed by mistake, sorry

sethkaz, 2021-01-21:
> > 1. The same can be said for the copper of the mounting holes.
>
> Moving them will create a ~big~ mess - I will try it out and see if the manufacturer says anything against it :)

Yes, you can try.  An alternative is to just reduce the size of the copper without changing the location.

Informaticore, 2021-01-22:
>  24. The connector for J4 is pretty fine in pitch. If the intention is for people to manually solder something in, maybe consider moving up to a 2mm pitch? There is plenty of room to do so.

we will keep it as is - if it makes trouble in practice we might change it. it is a rare feature.
With that - I am done with all the topics :)

MantaRayDeeJay, 2021-01-22:
I'm not fully agree about the point n°23 :
"I would recommend ditching the GND plane on the F.Cu layer completely. It is only being used in 2 places, and both of those can be replaced with a trace very quickly. **The disadvantage is that it adds a lot of copper features that could be places that act as antennas or worse.**"

I think that GND plane shape **will act as a shield if linked to the True internal GND Plane via Vias**.
If there is no lot of free space as on the layer 1 (Top), this is not very usefull, we can keep without it.
But I recommend to add it on the layer 4 (Bottom).

Moreover, PCB manufacturers don't like very much when there are a lot of copper to remove by the chemical process.
(It needs to use more "iron perchloride", therefore less ecological)

Thread 73 (2021-01-25):

Can't load 3d model with FreeCad

wassfila, 2021-01-25:
commit 43f4432fa330a83b1790b3b61581f4cfa3f51369

file -> Open -> "SuperPower-uC\original\SuperPower-uC-KiCad.kicad_pcb"

Error :
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

wassfila, 2021-01-25:
for the raspberry pi
commit
https://github.com/sethkaz/SuperPower/commit/d3b12cf72331b07d9264cd0fdebfc268e367fad2

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

2010019970909, 2021-01-25:
I cannot reproduce the error, but I remember having it a few months ago.

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

I only had the info this time:

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

MantaRayDeeJay, 2021-01-25:
@wassfila

Try to use the "KiCAD StepUp" Module ToolBar to open the file.

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

MantaRayDeeJay, 2021-01-25:
@wassfila

Which FreeCAD version are you using ?

wassfila, 2021-01-26:
I have Freecad 0.18 but I can try the latest, I placed the StepUpMod on the Mod folder
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

And I only have this menu
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

wassfila, 2021-01-26:
I think I was using a "fake" free version of Freecad I got from here

now I'm trying out this, that looks a bit more serious
https://www.freecadweb.org/downloads.php

Is that where you go it from ?

MantaRayDeeJay, 2021-01-26:
@wassfila

Try with the lastest v0.19 (Conda)
https://github.com/FreeCAD/FreeCAD/releases/tag/0.19_pre

Then use the Add-On Manager from the Tools Menu (last item) to download the "KiCAD StepUp" module.

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

wassfila, 2021-01-26:
with developer version 0.19, still the same issue,

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

I must be doing something radically wrong.
Starting from all wiki telling about installing from add-on manager but not telling how

The addon managed of version 0.18 looks like this
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

wassfila, 2021-01-26:
@MantaRayDeeJay thanks for your screenshot, that helped, only the version 0.19 show it and I was searching for S "StepUp" which it's in K "KicadStepUp" :)

wassfila, 2021-01-26:
now version 0.19 with StepUp installed from the addon manager still the same issue lol

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

I probably need the latest kicad then

MantaRayDeeJay, 2021-01-26:
@wassfila

The Add-On Manager of the version v0.18.4 is not Up to date.
I saw that they want to release the v0.18.5 (with the add-on Manager Up to date)

But currently, the easiest way to download FreeCAD modules is from the download manager of the v0.19.xxx series.

wassfila, 2021-01-26:
@MantaRayDeeJay are you running windows, cause I'm on windows
still v 0.19 look different
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

Can you screenshot your about menu ?

The toolbar is still different
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

MantaRayDeeJay, 2021-01-26:
@wassfila

I can see that on the last error screenshot, that it loads 3D models from "Raspberry" folder.
It could explain the issue.

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

Informaticore, 2021-01-26:
I am running 0.18 without the plug-in installed extra. Plain FreeCad and I just press open (folder on top) and open the pcb file. There is an error after loading the PCB but it is just because of something which can not be drawn but I see all things and the pcb is opened.

MantaRayDeeJay, 2021-01-26:
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

wassfila, 2021-01-26:
I tried these two versions and they end up on a different About menu info than your screenshot, weird :
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

MantaRayDeeJay, 2021-01-26:
I didn't have the lastest version (v0.19-23546)

wassfila, 2021-01-26:
It's just that Kicad does not like me, might be related to the install path, I installed on D: and the plugins gets installed on the C , if it's that stupid, it would be hard to debug
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

MantaRayDeeJay, 2021-01-26:
"C:\Program Files\KiCad\share\kicad\modules\packages3d" is the good path (same as mine)

Could you check KiCAD Footprint paths ?

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

wassfila, 2021-01-27:
It worked out, thanks a lot @MantaRayDeeJay it's thanks to your help, I realized that the StepUp Plugin was stupidly assuming that I have kicad installed on C:\ with a hardcoded path, I tried declaring the env var, even patched the hardcoded path in python, nothing helped, I had to copy all models on that C:\ path, then it worked.
It is so far fetched that today programs still do that, but then when I remember that both FreeCad and Kicad are free, I take it back, I used to hardcode paths myself when I was a kid lol

wassfila, 2021-01-27:
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

Closed 2021-01-27.

Thread 77 (2021-02-07):

Artemis - Stacked Version - Board Layout Review

MantaRayDeeJay, 2021-02-07:
_Review Status : Work in Progress_

**GLOBAL**

**Layout**
- [ ] Improve ESP32 Antenna clearance area. (See comments on Apollo board Review Ticket)

**DRC Issues**
- [ ] Solve GND MouTinG Holes issue. (Hole and Pad size can't be the same if you plan to connect the Mtg Hole to a net)

---
**DETAILS**

**Layout**

- ESP32 Antenna clearance

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

Tobi3566, 2021-02-08:
Some comments on the review points:
ESD: no low cost dev board that i know of has ESD on the usb input and this version is still kinda intended to be lowcost and possible to hand solder

U2: connected the same way basically all charger boards have the mosfet connected (some even have filled plane). also doesn't cause any electrical issues at all

VBat track width: not really possible with the layout and it is also sufficient for the expected current (slightly improved it already)

MantaRayDeeJay, 2021-02-09:
@Tobi3566
ESD Protection: why and how to protect microcontrollers efficiently
https://www.youtube.com/watch?v=56eZHBBuvsk
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

Thread 78 (2021-02-07):

Differences Apollo vs. Artemis

Informaticore, 2021-02-07:

wassfila, 2021-02-14:
- Why this 2 boards? Design decisions etc. => discussed in #76
- a section to describe the Features of Apollo / Artemis => done added here https://superpower.github.io/docs/uc/features/
- BOM variations for Apollo : TBD
# Shield variations
- currently x2 shields
- what are the differences ?
   - The LED only on the Apollo, cost delta to be estimated => Artemis could get an LED
   - USB CH340, CP2102 (3 Mbit vs 2 Mbit and battery detect feature, not used yet though) => $2.2 vs $0.7 which is 7% of the low cost Artemis board (for 5 only including shipping).
   - Apollo 4 layers / Artemis 2 layers => Apollo could be changed to 2 layers
   - possible also to make an adapter to an existing board

# Potential Shield Ideas
- how to differentiate shields e.g. sign, sub logo e.g. moon for Artemis,...
- recommendation to add UART chip name on each board (ESP32 - CH340 and ESP32 - CP2102)
# Logo
- the Apollo logo is a project logo (Apollo / Artemis / Leto)

# Done this week
- @MantaRayDeeJay review of Artemis
- most review findings fixed
- Artemis ready for prototyping
-

Thread 83 (2021-02-28):

Team Meeting 28/02/2021

wassfila, 2021-02-28:
# Review
- reviews missing logos
[ ] todo add logos

# Orders Status
## Original/Apollo
### regulator
 [x] regulator changed
 - variant directory `apollo-board_TPS63060`
 - closed PR https://github.com/SuperPower/Apollo/pull/1
 - res value section `9.2.2.4 Step Four: Setting the Output Voltage` from https://www.ti.com/lit/ds/symlink/tps63060.pdf =>
 - 5V : (R49 110K R51 1M)
 - 3.3V : (R47 100K R50 560K)
 [ ] review res values before going to production
### usb-C
 - we used a specific usb-c connector `usb_c:usb-c-usb4105`, but we should use another pin compatible one that is more common

Thread 84 (2021-03-07):

Team Meeting 07/03/2021

wassfila, 2021-03-07:
# Boards status
- esp_shield : done
- Apollo : done
- Artemis : done
  - increased capacitors value : done

# Order Status
- Mirko will take care of it on Monday

# Firmware
multiple environments to be supported
- ArduinoIDE
- PlatforimIO (Arduino Framework)

First prio Arduino and then Platform

do we create a board or use "esp32dev" ?
- e.g. built in led declaration,...
- esp32dev, easier to start with

creating libraries
[ ] ltc

[x] Artemis library already available
will be replicated on a repo so that it can be managed as a dependency

we will provide a single entry point for the user e.g. Artemis.

# Google drive status
- not organized
- no rights available for the core team so not possible to improve it
- suggestion to move all uC files in a new directory "SuperPower-uC" on the top and reorganize all documents into it

# QR code
- it is possible to configure the rate of redundancy but could not find a program for that
- if possible to fit 10x10 or 12x12 (trying to place some vias in black spots) + the 5x5 for text

Thread 86 (2021-04-27):

Prototype v1.0 Testing Protocol

Informaticore, 2021-04-27:
- [ ] USB-C Delivers 5V when connected
- [ ] USB-UART connection established
- [ ] auto Flashing ESP32
- [ ] enable 3.3V via GPIO
- [ ] enable 5V via GPIO
- [ ] i2C detect LTC
- [ ] i2C detect RTC
- [ ] ... TBD

dr-stefan-krank, 2021-05-02:
Noticeable coil whining on different loads for 3v3 MCU regulator.

MantaRayDeeJay, 2021-05-14:
SOT23-3 DMN3023L MOSFETs correction :
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

MantaRayDeeJay, 2021-05-23:
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

Ceramic capacitor whinings come from a "not good working" of the LTC4162-L chip due to the SOT23-3 DMN3023L MOSFETs issue

MantaRayDeeJay, 2021-07-24:
Ibat Rsense (R20) :
Currently, the resistor used is a 0805 68mohm 0,25W
Buck-Boost chips can sink more than 2A from the battery.
In this case, vsns = 32mV x4 (128mV) @I=2A -> 0,256W.
There are 2 chips on board, so Power can raise about 0,5W.
I recommand to replace the 0805 0,25W by a 1206 1W resistor.

Thread 87 (2021-04-29):

Apollo Findings and Fixes

Informaticore, 2021-04-29:
- [ ] Change U8 Footprint from SOT23-6 to WSON
- [ ] Connect U8 VIN to actual VIN (missing label on the sheet)

MantaRayDeeJay, 2021-07-17:
Increase Track width for Power lines : Details

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
