Informaticore/SuperPower/SuperPower-uC/original/SuperPower-uC-KiCad.kicad_pcb

## KiCad design SuperPower-uC/original/SuperPower-uC-KiCad.kicad_pcb (2020-12-30)

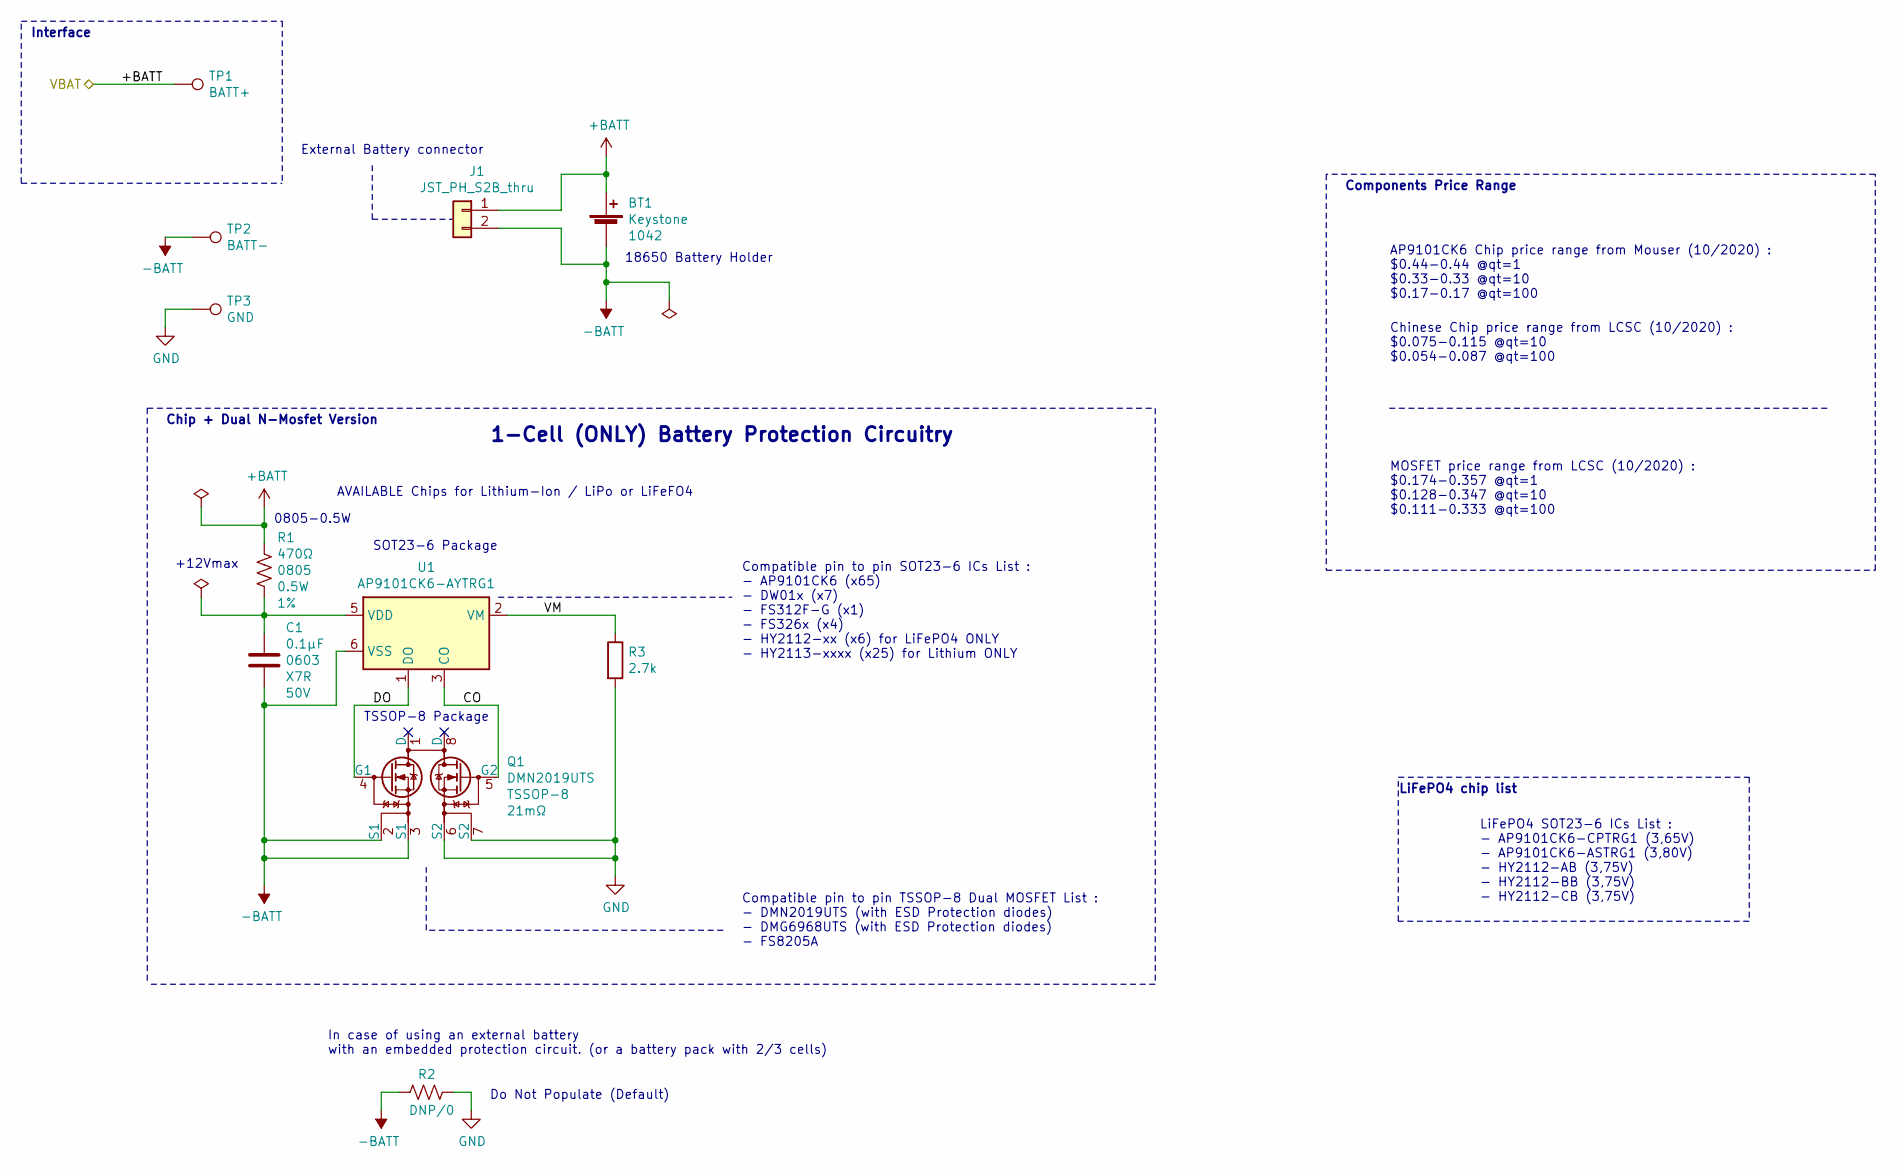
[picture p10: schematic battery_protection.sch, SuperPower-uC]

Parts:
BT1: Battery_Cell_Holder_18650_SMT_1042; BatteryHolder_Keystone_1042_1x18650; Farnell_ref ?
C1: CC0603JRX7R9BB104; C_0603_1608Metric; Farnell_ref 3369214
J1: JST_PH_S2B_thru; JST_PH_S2B-PH-K_1x02_P2.00mm_Horizontal; Farnell_ref 9491902
Q1: DMN2019UTS; TSSOP-8_4.4x3mm_P0.65mm; Farnell_check_date 2020-12-05
R1: ERJ-P06F4700V; R_0805_2012Metric; Farnell_check_date 2020-12-17
R2: DNP/0; R_0603_1608Metric
R3: 2.7k; R_0603_1608Metric
TP1: BATT+; TestPoint_Pad_D1.0mm
TP2: BATT-; TestPoint_Pad_D1.0mm
TP3: GND; TestPoint_Pad_D1.0mm
U1: AP9101CK6-AYTRG1; SOT-23-6; Farnell_check_date 2020-11-28

Connections:
+BATT: BT1.1 (+), J1.1, R1.1, TP1.1; also elsewhere on the board
-BATT: BT1.2 (-), C1.2, J1.2, Q1.2 (S1), Q1.3 (S1), R2.2, TP2.1, U1.6 (VSS)
/Battery Module/CO: Q1.5 (G2), U1.3 (CO)
/Battery Module/DO: Q1.4 (G1), U1.1 (DO)
/Battery Module/VM: R3.1, U1.2 (VM)
GND: Q1.6 (S2), Q1.7 (S2), R2.1, R3.2, TP3.1; also elsewhere on the board
unnamed: C1.1, R1.2, U1.5 (VDD)

Notes on the sheet:
SOT23-6 Package
TSSOP-8 Package
Compatible pin to pin SOT23-6 ICs List : - AP9101CK6 (x65) - DW01x (x7) - FS312F-G (x1) - FS326x (x4) - HY2112-xx (x6) for LiFePO4 ONLY - HY2113-xxxx (x25) for Lithium ONLY
AVAILABLE Chips for Lithium-Ion / LiPo or LiFeFO4
AP9101CK6 Chip price range from Mouser (10/2020) : $0.44-0.44 @qt=1 $0.33-0.33 @qt=10 $0.17-0.17 @qt=100
Compatible pin to pin TSSOP-8 Dual MOSFET List : - DMN2019UTS (with ESD Protection diodes) - DMG6968UTS (with ESD Protection diodes) - FS8205A
MOSFET price range from LCSC (10/2020) : $0.174-0.357 @qt=1 $0.128-0.347 @qt=10 $0.111-0.333 @qt=100
LiFePO4 SOT23-6 ICs List : - AP9101CK6-CPTRG1 (3,65V) - AP9101CK6-ASTRG1 (3,80V) - HY2112-AB (3,75V) - HY2112-BB (3,75V) - HY2112-CB (3,75V)
Chinese Chip price range from LCSC (10/2020) : $0.075-0.115 @qt=10 $0.054-0.087 @qt=100
Chip + Dual N-Mosfet Version
LiFePO4 chip list
In case of using an external battery with an embedded protection circuit. (or a battery pack with 2/3 cells)
External Battery connector
Interface
Components Price Range
18650 Battery Holder
1-Cell (ONLY) Battery Protection Circuitry
+12Vmax
Do Not Populate (Default)
0805-0.5W

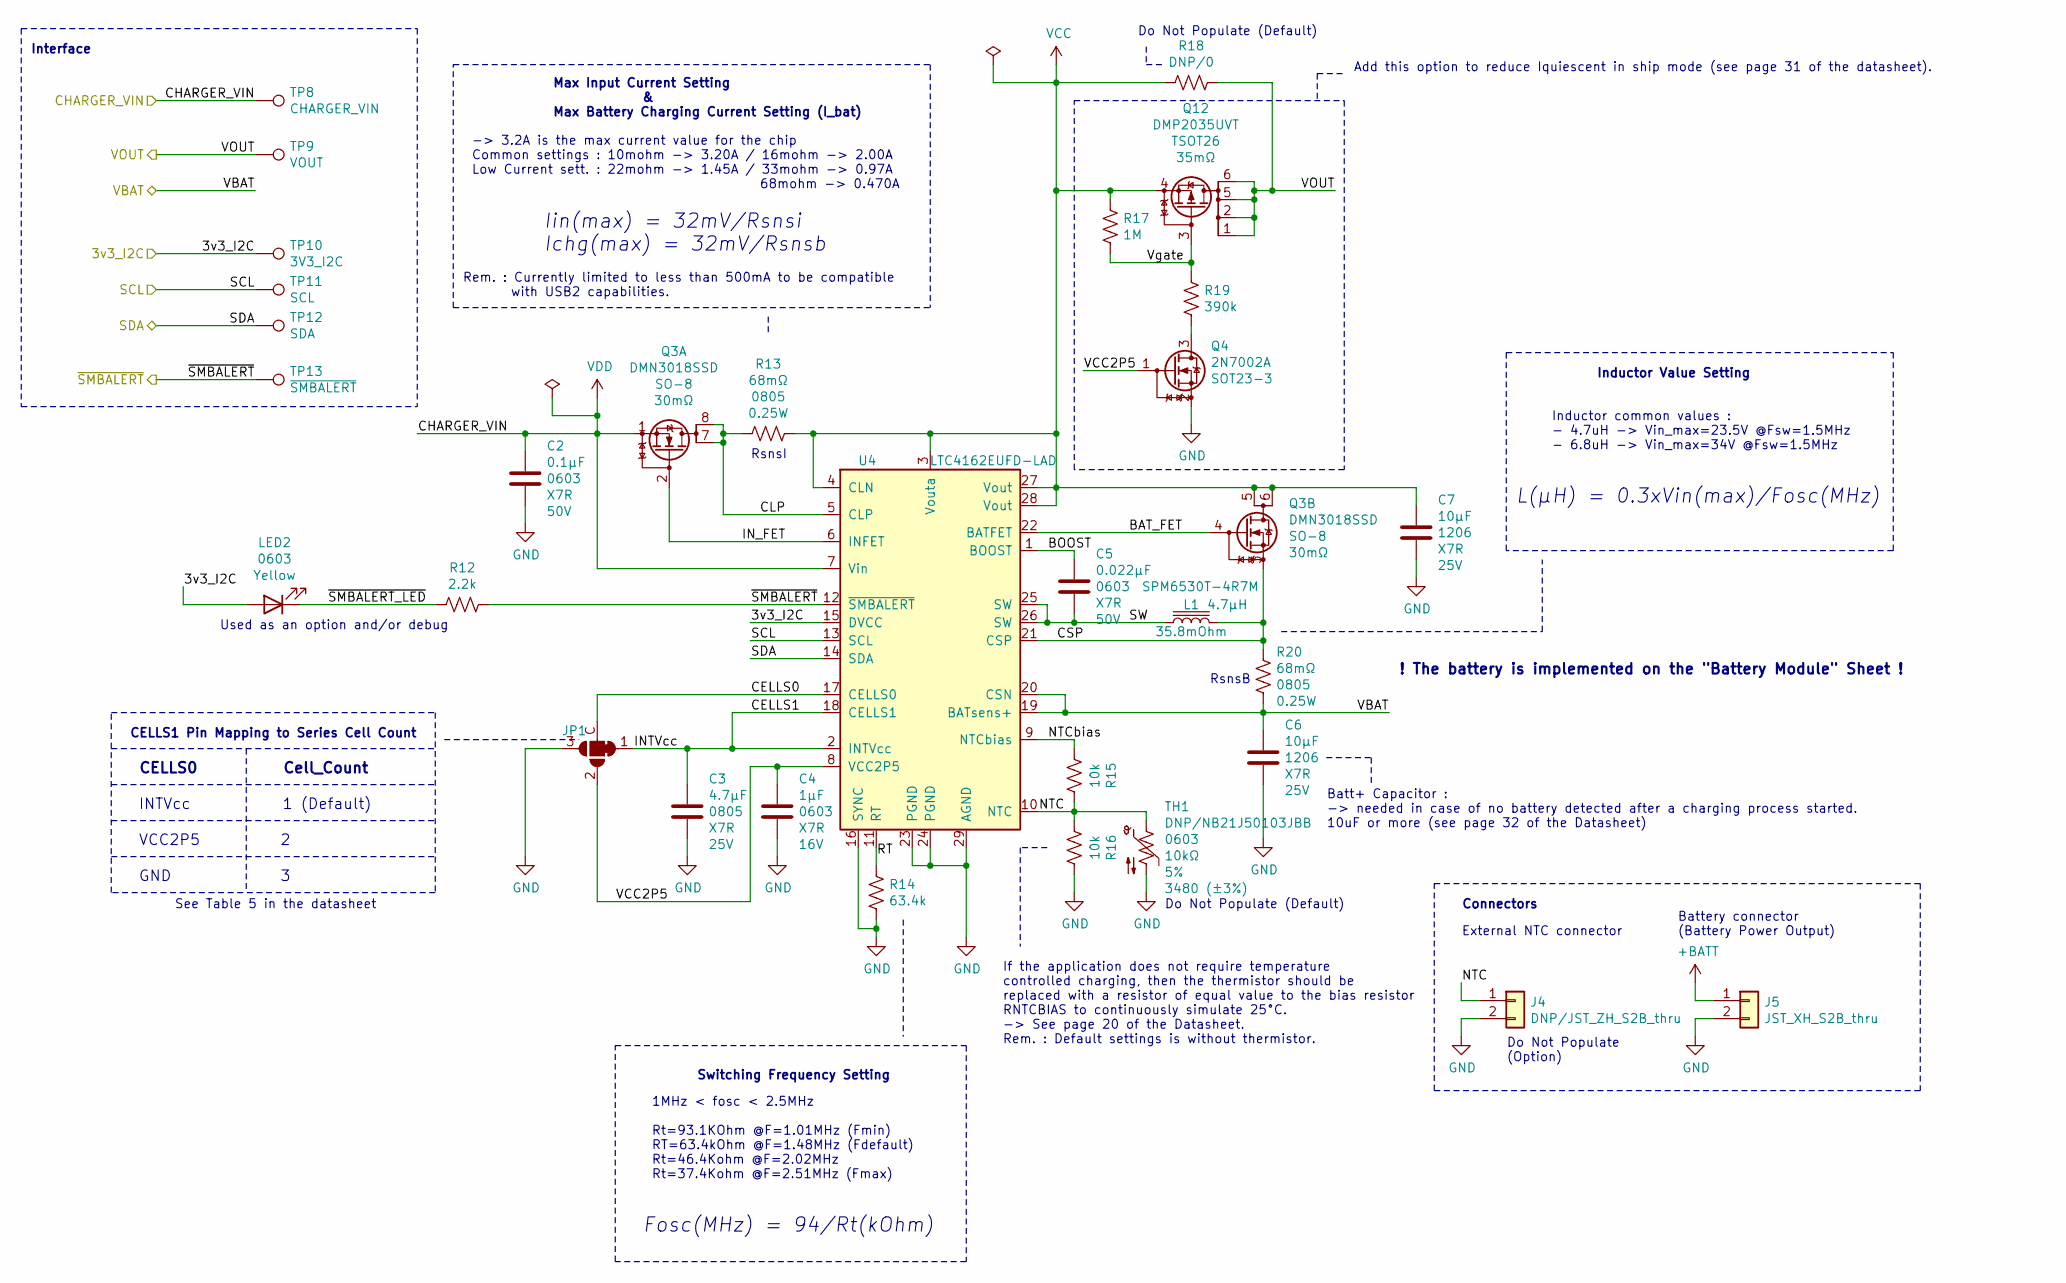
[picture p11: schematic charger.sch, SuperPower-uC]

Parts:
C2: CC0603JRX7R9BB104; C_0603_1608Metric; Farnell_ref 3369214
C3: TMK212AB7475KG-T; C_0805_2012Metric; Farnell_ref 2779199
C4: CL10B105KO8NNNC; C_0603_1608Metric; Farnell_ref 3013416
C5: CL10B223KB8NNNC; C_0603_1608Metric; Farnell_ref 3013425
C6, C7: CL31B106KAHNNNE; C_1206_3216Metric; Farnell_ref 3013526
J4: DNP/JST_ZH_S2B_thru; JST_ZH_S2B-ZR_1x02_P1.50mm_Horizontal; Farnell_ref 9491813
J5: JST_XH_S2B_thru; JST_XH_S2B-XH-A_1x02_P2.50mm_Horizontal; Farnell_ref 1516289
JP1: SolderJumper_4_Bridged_1C; SolderJumper-4_P2.0mm_Bridged1C_TrianglePad1.0x1.5mm_Number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
L1: SPM6530T-4R7M; L_TDK_SPM6530T; LCSC_ref C76857
LED2: 150060YS75000_0603; LED_0603_1608Metric; Farnell_ref 2322074
Q3: DMN3018SSD; SO-8_3.9x4.9mm_P1.27mm; Farnell_check_date 2020-12-05
Q4: 2N7002A; SOT-23; Farnell_ref 3127180
Q12: DMP2035UVT; SOT-23-6; Farnell_ref 3405183
R12: 2.2k; R_0603_1608Metric
R13, R20: RL0805FR-7W0R068L; R_0805_2012Metric; Farnell_ref 8067694
R14: 63.4k; R_0603_1608Metric
R15, R16: 10k; R_0603_1608Metric
R17: 1M; R_0603_1608Metric
R18: DNP/0; R_0603_1608Metric
R19: 390k; R_0603_1608Metric
TH1: DNP/NB21J50103JBB; R_0603_1608Metric; Farnell_ref 1672340
TP8: CHARGER_VIN; TestPoint_Pad_D1.0mm
TP9: VOUT; TestPoint_Pad_D1.0mm
TP10: 3V3_I2C; TestPoint_Pad_D1.0mm
TP11: SCL; TestPoint_Pad_D1.0mm
TP12: SDA; TestPoint_Pad_D1.0mm
TP13: ~SMBALERT; TestPoint_Pad_D1.0mm
U4: LTC4162EUFD-LAD; QFN-28-1EP_4x5mm_P0.5mm_EP2.65x3.65mm_ThermalVias; Farnell_check_date 2020-11-22

Connections:
+BATT: C6.1, J5.1, R20.1, U4.19 (BATsens+), U4.20 (CSN); also elsewhere on the board
/Charging Module/3v3_I2C: LED2.2 (A), TP10.1, U4.15 (DVCC); also elsewhere on the board
/Charging Module/BAT_FET: Q3.4 (G), U4.22 (BATFET)
/Charging Module/BOOST: C5.1, U4.1 (BOOST)
/Charging Module/CELLS0: JP1.C (Com), U4.17 (CELLS0)
/Charging Module/CELLS1: C3.1, JP1.1 (A), U4.2 (INTVcc), U4.18 (CELLS1)
/Charging Module/CLP: Q3.7 (D), Q3.8 (D), R13.2, U4.5 (CLP)
/Charging Module/CSP: L1.2, Q3.3 (S), R20.2, U4.21 (CSP)
/Charging Module/IN_FET: Q3.2 (G), U4.6 (INFET)
/Charging Module/NTC: J4.1, R15.1, R16.2, TH1.1, U4.10 (NTC)
/Charging Module/NTCbias: R15.2, U4.9 (NTCbias)
/Charging Module/RT: R14.2, U4.11 (RT)
/Charging Module/SW: C5.2, L1.1, U4.25 (SW), U4.26 (SW)
/Charging Module/VCC2P5: C4.1, JP1.2 (B), Q4.1 (G), U4.8 (VCC2P5)
/Charging Module/Vgate: Q12.3 (G), R17.2, R19.1
/Charging Module/~SMBALERT_LED: LED2.1 (K), R12.2
/Regulator and Cut-Off Module/VIN: Q12.1 (D), Q12.2 (D), Q12.5 (D), Q12.6 (D), R18.1, TP9.1; also elsewhere on the board
/SCL: TP11.1, U4.13 (SCL); also elsewhere on the board
/SDA: TP12.1, U4.14 (SDA); also elsewhere on the board
/~SMBALERT: R12.1, TP13.1, U4.12 (~SMBALERT); also elsewhere on the board
GND: C2.2, C3.2, C4.2, C6.2, C7.2, J4.2, J5.2, JP1.3 (C), Q4.2 (S), R14.1, R16.1, TH1.2, U4.16 (SYNC), U4.23 (PGND), U4.24 (PGND), U4.29 (AGND); also elsewhere on the board
unnamed: Q4.3 (D), R19.2
VCC: C7.1, Q3.5 (D), Q3.6 (D), Q12.4 (S), R13.1, R17.1, R18.2, U4.3 (Vouta), U4.4 (CLN), U4.27 (Vout), U4.28 (Vout)
VDD: C2.1, Q3.1 (S), TP8.1, U4.7 (Vin); also elsewhere on the board

Notes on the sheet:
RsnsB
RsnsI
If the application does not require temperature controlled charging, then the thermistor should be replaced with a resistor of equal value to the bias resistor RNTCBIAS to continuously simulate 25°C. -> See page 20 of the Datasheet. Rem. : Default settings is without thermistor.
Batt+ Capacitor : -> needed in case of no battery detected after a charging process started. 10uF or more (see page 32 of the Datasheet)
1MHz < fosc < 2.5MHz Rt=93.1KOhm @F=1.01MHz (Fmin) RT=63.4kOhm @F=1.48MHz (Fdefault) Rt=46.4Kohm @F=2.02MHz Rt=37.4Kohm @F=2.51MHz (Fmax)
Inductor common values : - 4.7uH -> Vin_max=23.5V @Fsw=1.5MHz - 6.8uH -> Vin_max=34V @Fsw=1.5MHz
Add this option to reduce Iquiescent in ship mode (see page 31 of the datasheet).
External NTC connector
Switching Frequency Setting
Max Input Current Setting & Max Battery Charging Current Setting (I_bat)
-> 3.2A is the max current value for the chip Common settings : 10mohm -> 3.20A / 16mohm -> 2.00A Low Current sett. : 22mohm -> 1.45A / 33mohm -> 0.97A 68mohm -> 0.470A
Inductor Value Setting
Battery connector (Battery Power Output)
Used as an option and/or debug
See Table 5 in the datasheet
Connectors
! The battery is implemented on the "Battery Module" Sheet !
Iin(max) = 32mV/Rsnsi Ichg(max) = 32mV/Rsnsb
Fosc(MHz) = 94/Rt(kOhm)
L(µH) = 0.3xVin(max)/Fosc(MHz)
CELLS1 Pin Mapping to Series Cell Count
CELLS0
Cell_Count
INTVcc
VCC2P5
GND
1 (Default)
Rem. : Currently limited to less than 500mA to be compatible with USB2 capabilities.
Interface
Do Not Populate (Option)
Do Not Populate (Default)

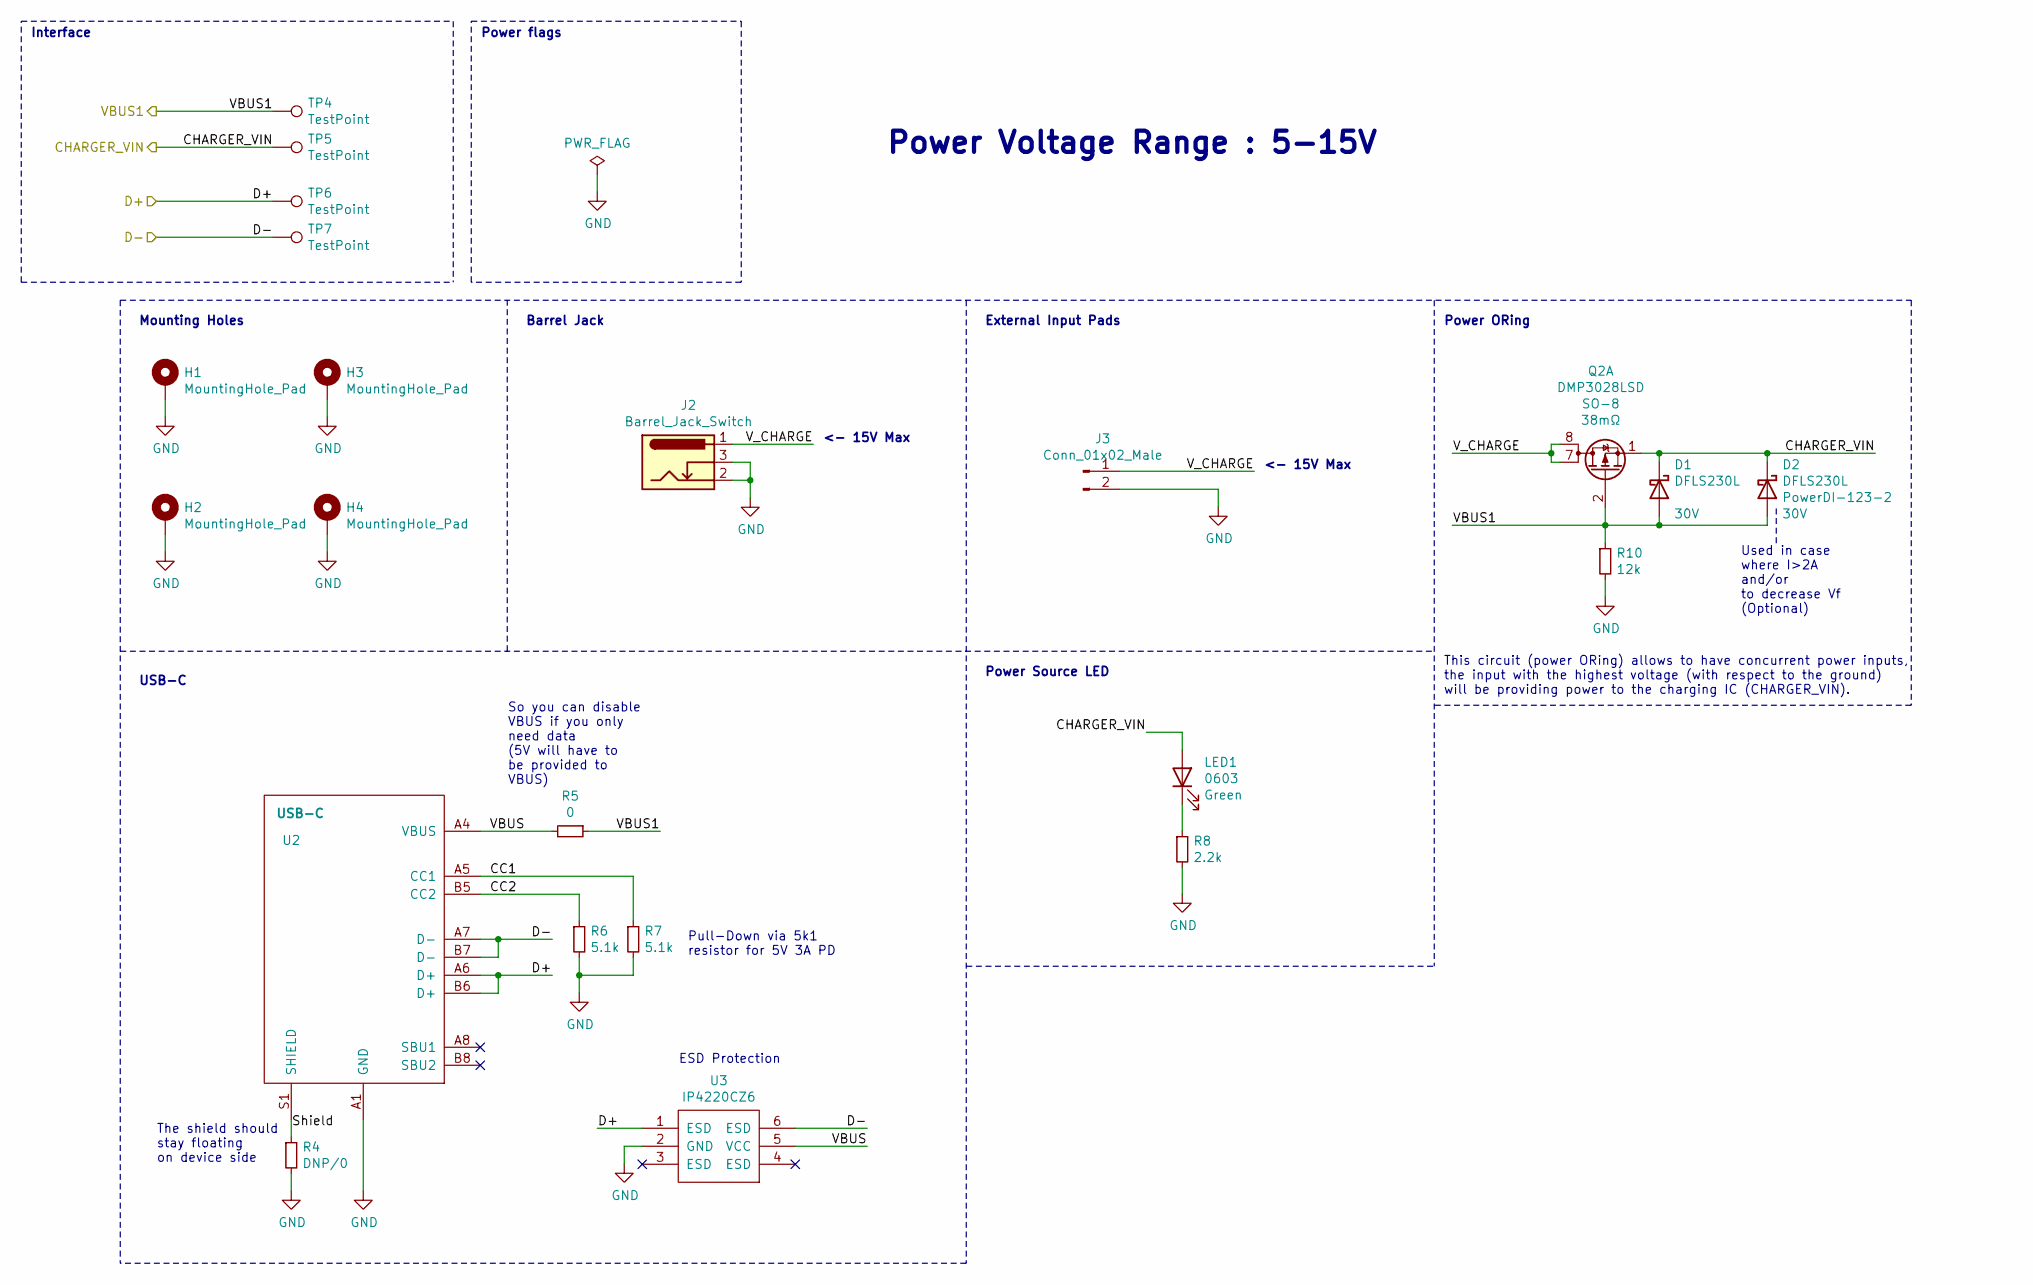
[picture p12: schematic charger_io.sch, SuperPower-uC]

Parts:
D1, D2: DFLS230L; D_PowerDI-123; Farnell_ref 1858663
H1, H3: MountingHole_Pad; MountingHole_2.7mm_M2.5_Pad_Via
H2, H4: MountingHole_Pad; MountingHole_2.7mm_Pad_Via
J2: Barrel_Jack_Switch; BarrelJack_Wuerth_6941xx301002
J3: Conn_01x02_Male; ext_input_pads
LED1: 150060VS75000_0603; LED_0603_1608Metric; Farnell_ref 2322073
Q2: DMP3028LSD; SO-8_3.9x4.9mm_P1.27mm; Farnell_check_date 2020-12-05
R4: DNP/0; R_0603_1608Metric
R5: 0; R_0603_1608Metric
R6, R7: 5.1k; R_0603_1608Metric
R8: 2.2k; R_0603_1608Metric
R10: 12k; R_0603_1608Metric
TP4, TP5, TP6, TP7: TestPoint; TestPoint_Pad_D1.0mm
U2: USB-C; usb-c-usb4110
U3: IP4220CZ6; TSOP-6_1.65x3.05mm_P0.95mm

Connections:
/Charger inputs and USB IO/CC1: R7.1, U2.A5 (CC1)
/Charger inputs and USB IO/CC2: R6.1, U2.B5 (CC2)
/Charger inputs and USB IO/Shield: R4.1, U2.S1 (SHIELD)
/Charger inputs and USB IO/V_CHARGE: J2.1, J3.1, Q2.7 (D), Q2.8 (D)
/D+: TP6.1, U2.A6 (D+), U2.B6 (D+), U3.1 (ESD); also elsewhere on the board
/D-: TP7.1, U2.A7 (D-), U2.B7 (D-), U3.6 (ESD); also elsewhere on the board
/VBUS1: D1.2 (A), D2.2 (A), Q2.2 (G), R5.1, R10.1, TP4.1; also elsewhere on the board
GND: H1.1, H2.1, H3.1, H4.1, J2.2, J2.3, J3.2, R4.2, R6.2, R7.2, R8.2, R10.2, U2.A1 (GND), U2.A12 (GND), U2.B1 (GND), U2.B12 (GND), U3.2 (GND); also elsewhere on the board
unnamed: LED1.1 (K), R8.1
VBUS: R5.2, U2.A4 (VBUS), U2.A9 (VBUS), U2.B4 (VBUS), U2.B9 (VBUS), U3.5 (VCC)
VDD: D1.1 (K), D2.1 (K), LED1.2 (A), Q2.1 (S), TP5.1; also elsewhere on the board

Notes on the sheet:
Pull-Down via 5k1 resistor for 5V 3A PD
Barrel Jack
External Input Pads
USB-C
So you can disable VBUS if you only need data (5V will have to be provided to VBUS)
ESD Protection
The shield should stay floating on device side
Power ORing
This circuit (power ORing) allows to have concurrent power inputs, the input with the highest voltage (with respect to the ground) will be providing power to the charging IC (CHARGER_VIN).
Power Source LED
Interface
Power Voltage Range : 5-15V
<- 15V Max
Mounting Holes
Power flags
Used in case where I>2A and/or to decrease Vf (Optional)

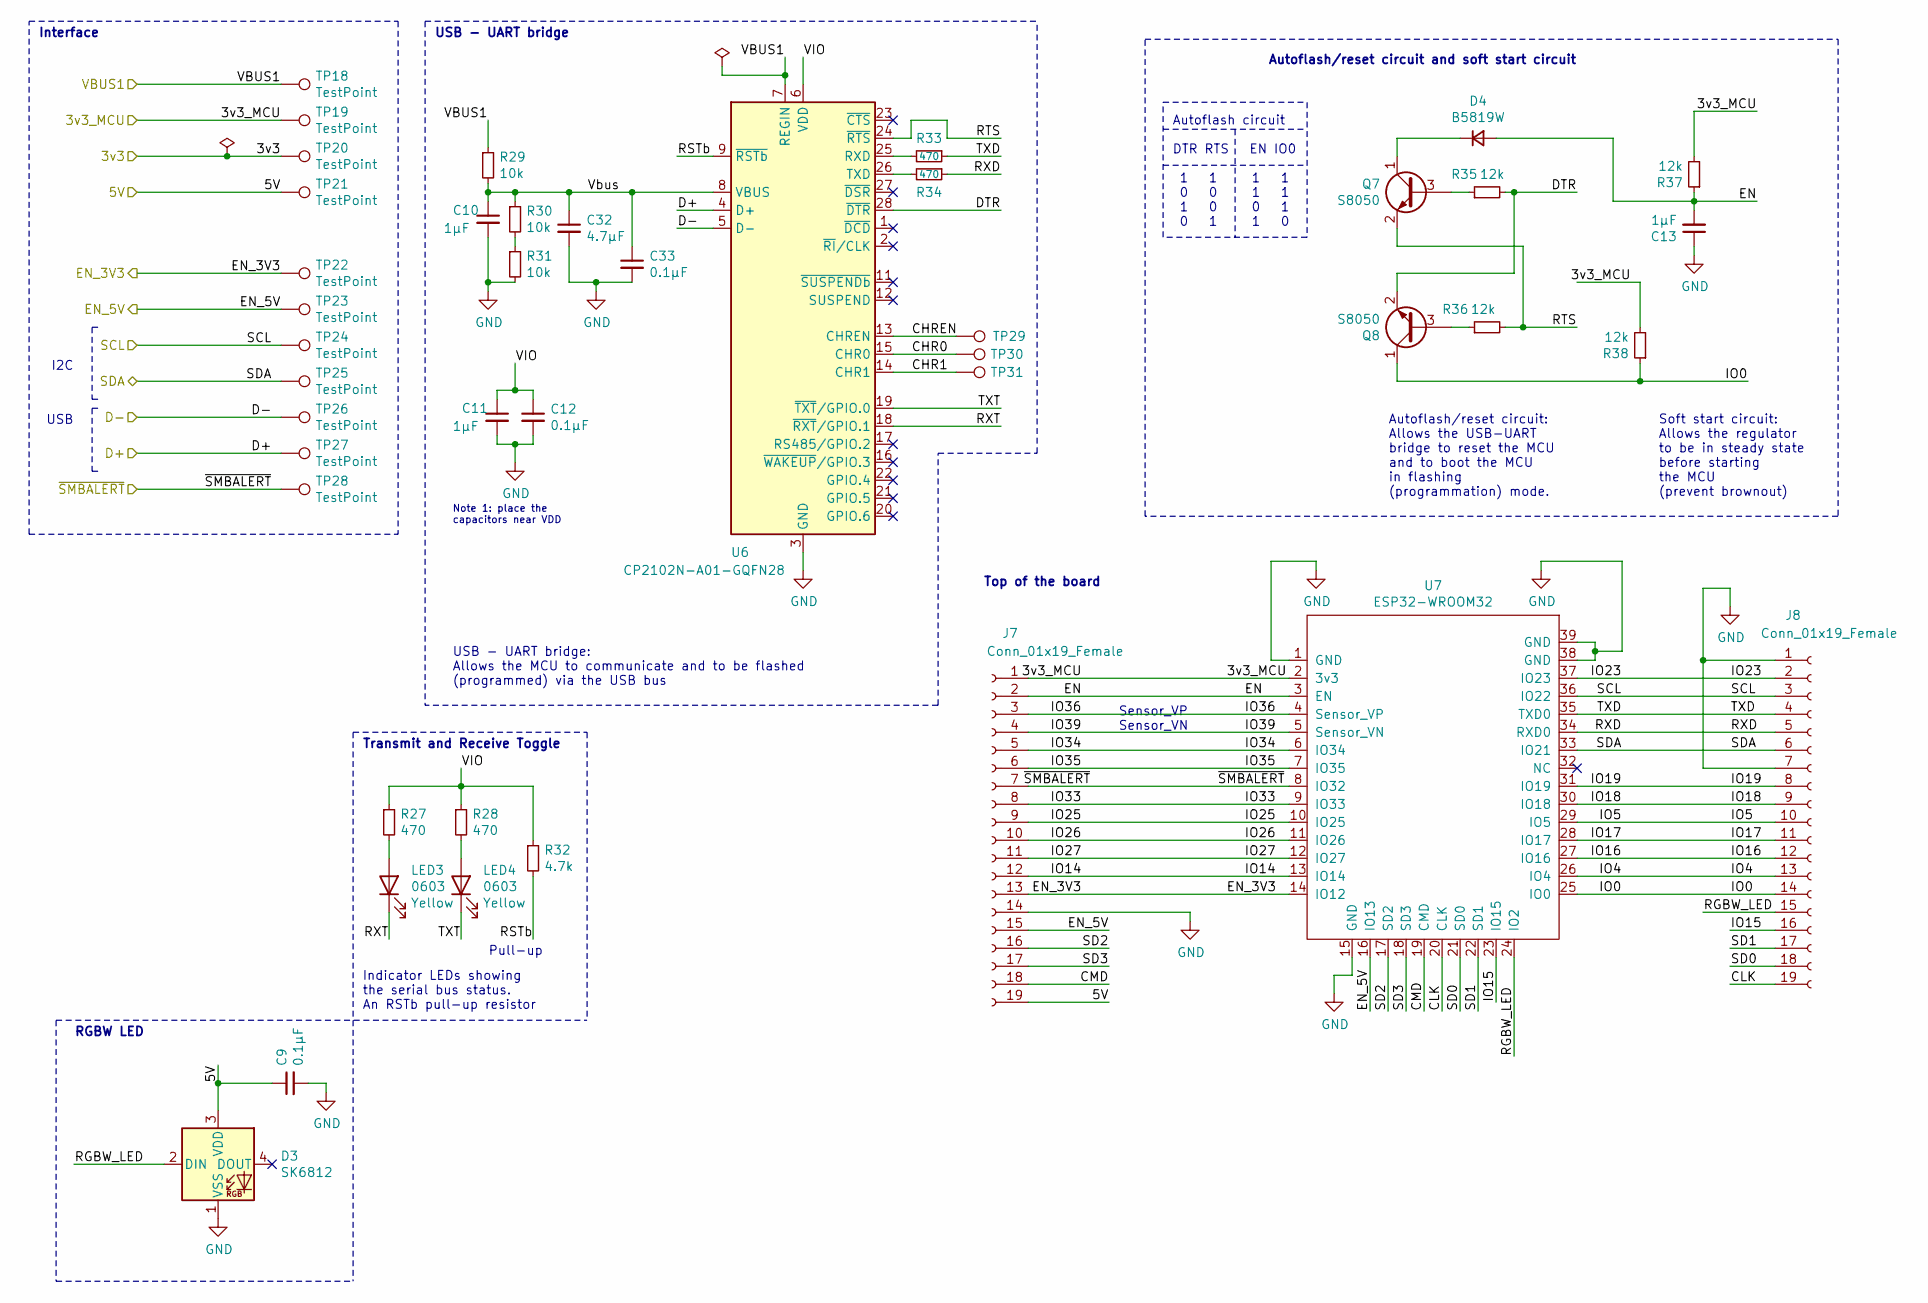
[picture p13: schematic mcu.sch, SuperPower-uC]

Parts:
C9, C12, C33: 0.1µF; C_0603_1608Metric
C10, C11, C13: 1µF; C_0603_1608Metric
C32: 4.7µF; C_0603_1608Metric
D3: SK6812; LED_SK6812_PLCC4_5.0x5.0mm_P3.2mm
D4: B5819W; D_SOD-123
J7, J8: Conn_01x19_Female; PinSocket_1x19_P2.54mm_Vertical
LED3, LED4: 150060YS75000_0603; LED_0603_1608Metric; Farnell_ref 2322074
Q7, Q8: S8050; SOT-23
R27, R28, R33, R34: 470; R_0603_1608Metric
R29, R30, R31: 10k; R_0603_1608Metric
R32: 4.7k; R_0603_1608Metric
R35, R36, R37, R38: 12k; R_0603_1608Metric
TP18, TP19, TP20, TP21, TP22, TP23, TP24, TP25, TP26, TP27, TP28, TP29, TP30, TP31: TestPoint; TestPoint_Pad_D1.0mm
U6: CP2102N-A01-GQFN28; QFN-28-1EP_5x5mm_P0.5mm_EP3.35x3.35mm
U7: ESP32-WROOM32; ESP32-WROOM-32; LCSC C82899

Connections:
/D+: TP27.1, U6.4 (D+); also elsewhere on the board
/D-: TP26.1, U6.5 (D-); also elsewhere on the board
/MCU Module/3v3: TP20.1; also elsewhere on the board
/MCU Module/3v3_MCU: J7.1, R37.2, R38.2, TP19.1, U7.2 (3v3); also elsewhere on the board
/MCU Module/5V: C9.1, D3.3 (VDD), J7.19, TP21.1; also elsewhere on the board
/MCU Module/CHR0: TP30.1, U6.15 (CHR0)
/MCU Module/CHR1: TP31.1, U6.14 (CHR1)
/MCU Module/CHREN: TP29.1, U6.13 (CHREN)
/MCU Module/CLK: J8.19, U7.20 (CLK)
/MCU Module/CMD: J7.18, U7.19 (CMD)
/MCU Module/DTR: Q8.2 (E), R35.2, U6.28 (~DTR)
/MCU Module/EN: C13.2, D4.2 (A), J7.2, R37.1, U7.3 (EN)
/MCU Module/EN_3V3: J7.13, TP22.1, U7.14 (IO12); also elsewhere on the board
/MCU Module/EN_5V: J7.15, TP23.1, U7.16 (IO13); also elsewhere on the board
/MCU Module/IO0: J8.14, Q8.1 (C), R38.1, U7.25 (IO0)
/MCU Module/IO4: J8.13, U7.26 (IO4)
/MCU Module/IO5: J8.10, U7.29 (IO5)
/MCU Module/IO14: J7.12, U7.13 (IO14)
/MCU Module/IO15: J8.16, U7.23 (IO15)
/MCU Module/IO16: J8.12, U7.27 (IO16)
/MCU Module/IO17: J8.11, U7.28 (IO17)
/MCU Module/IO18: J8.9, U7.30 (IO18)
/MCU Module/IO19: J8.8, U7.31 (IO19)
/MCU Module/IO23: J8.2, U7.37 (IO23)
/MCU Module/IO25: J7.9, U7.10 (IO25)
/MCU Module/IO26: J7.10, U7.11 (IO26)
/MCU Module/IO27: J7.11, U7.12 (IO27)
/MCU Module/IO33: J7.8, U7.9 (IO33)
/MCU Module/IO34: J7.5, U7.6 (IO34)
/MCU Module/IO35: J7.6, U7.7 (IO35)
/MCU Module/IO36: J7.3, U7.4 (Sensor_VP)
/MCU Module/IO39: J7.4, U7.5 (Sensor_VN)
/MCU Module/RGBW_LED: D3.2 (DIN), J8.15, U7.24 (IO2)
/MCU Module/RSTb: R32.2, U6.9 (~RSTb)
/MCU Module/RTS: Q7.2 (E), R36.2, U6.24 (~RTS)
/MCU Module/RXD: J8.5, R34.1, U7.34 (RXD0)
/MCU Module/RXT: LED3.1 (K), U6.18 (~RXT~/GPIO.1)
/MCU Module/SD0: J8.18, U7.21 (SD0)
/MCU Module/SD1: J8.17, U7.22 (SD1)
/MCU Module/SD2: J7.16, U7.17 (SD2)
/MCU Module/SD3: J7.17, U7.18 (SD3)
/MCU Module/TXD: J8.4, R33.1, U7.35 (TXD0)
/MCU Module/TXT: LED4.1 (K), U6.19 (~TXT~/GPIO.0)
/MCU Module/VIO: C11.1, C12.1, R27.1, R28.1, R32.1, U6.6 (VDD)
/MCU Module/Vbus: C10.1, C32.1, C33.1, R29.2, R30.1, U6.8 (VBUS)
/SCL: J8.3, TP24.1, U7.36 (IO22); also elsewhere on the board
/SDA: J8.6, TP25.1, U7.33 (IO21); also elsewhere on the board
/VBUS1: R29.1, TP18.1, U6.7 (REGIN); also elsewhere on the board
/~SMBALERT: J7.7, TP28.1, U7.8 (IO32); also elsewhere on the board
GND: C9.2, C10.2, C11.2, C12.2, C13.1, C32.2, C33.2, D3.1 (VSS), J7.14, J8.1, J8.7, R31.2, U6.3 (GND), U6.29 (GND), U7.1 (GND), U7.15 (GND), U7.38 (GND), U7.39 (GND); also elsewhere on the board
unnamed: D4.1 (K), Q7.1 (C)
unnamed: LED3.2 (A), R27.2
unnamed: LED4.2 (A), R28.2
unnamed: Q7.3 (B), R35.1
unnamed: Q8.3 (B), R36.1
unnamed: R30.2, R31.1
unnamed: R33.2, U6.25 (RXD)
unnamed: R34.2, U6.26 (TXD)

Notes on the sheet:
USB - UART bridge
Autoflash circuit DTR RTS EN IO0 1 1 1 1 0 0 1 1 1 0 0 1 0 1 1 0
Autoflash/reset circuit and soft start circuit
Transmit and Receive Toggle
Interface
Pull-up
Note 1: place the capacitors near VDD
Top of the board
Sensor_VP Sensor_VN
Indicator LEDs showing the serial bus status. An RSTb pull-up resistor
Soft start circuit: Allows the regulator to be in steady state before starting the MCU (prevent brownout)
USB - UART bridge: Allows the MCU to communicate and to be flashed (programmed) via the USB bus
I2C
USB
RGBW LED
Autoflash/reset circuit: Allows the USB-UART bridge to reset the MCU and to boot the MCU in flashing (programmation) mode.

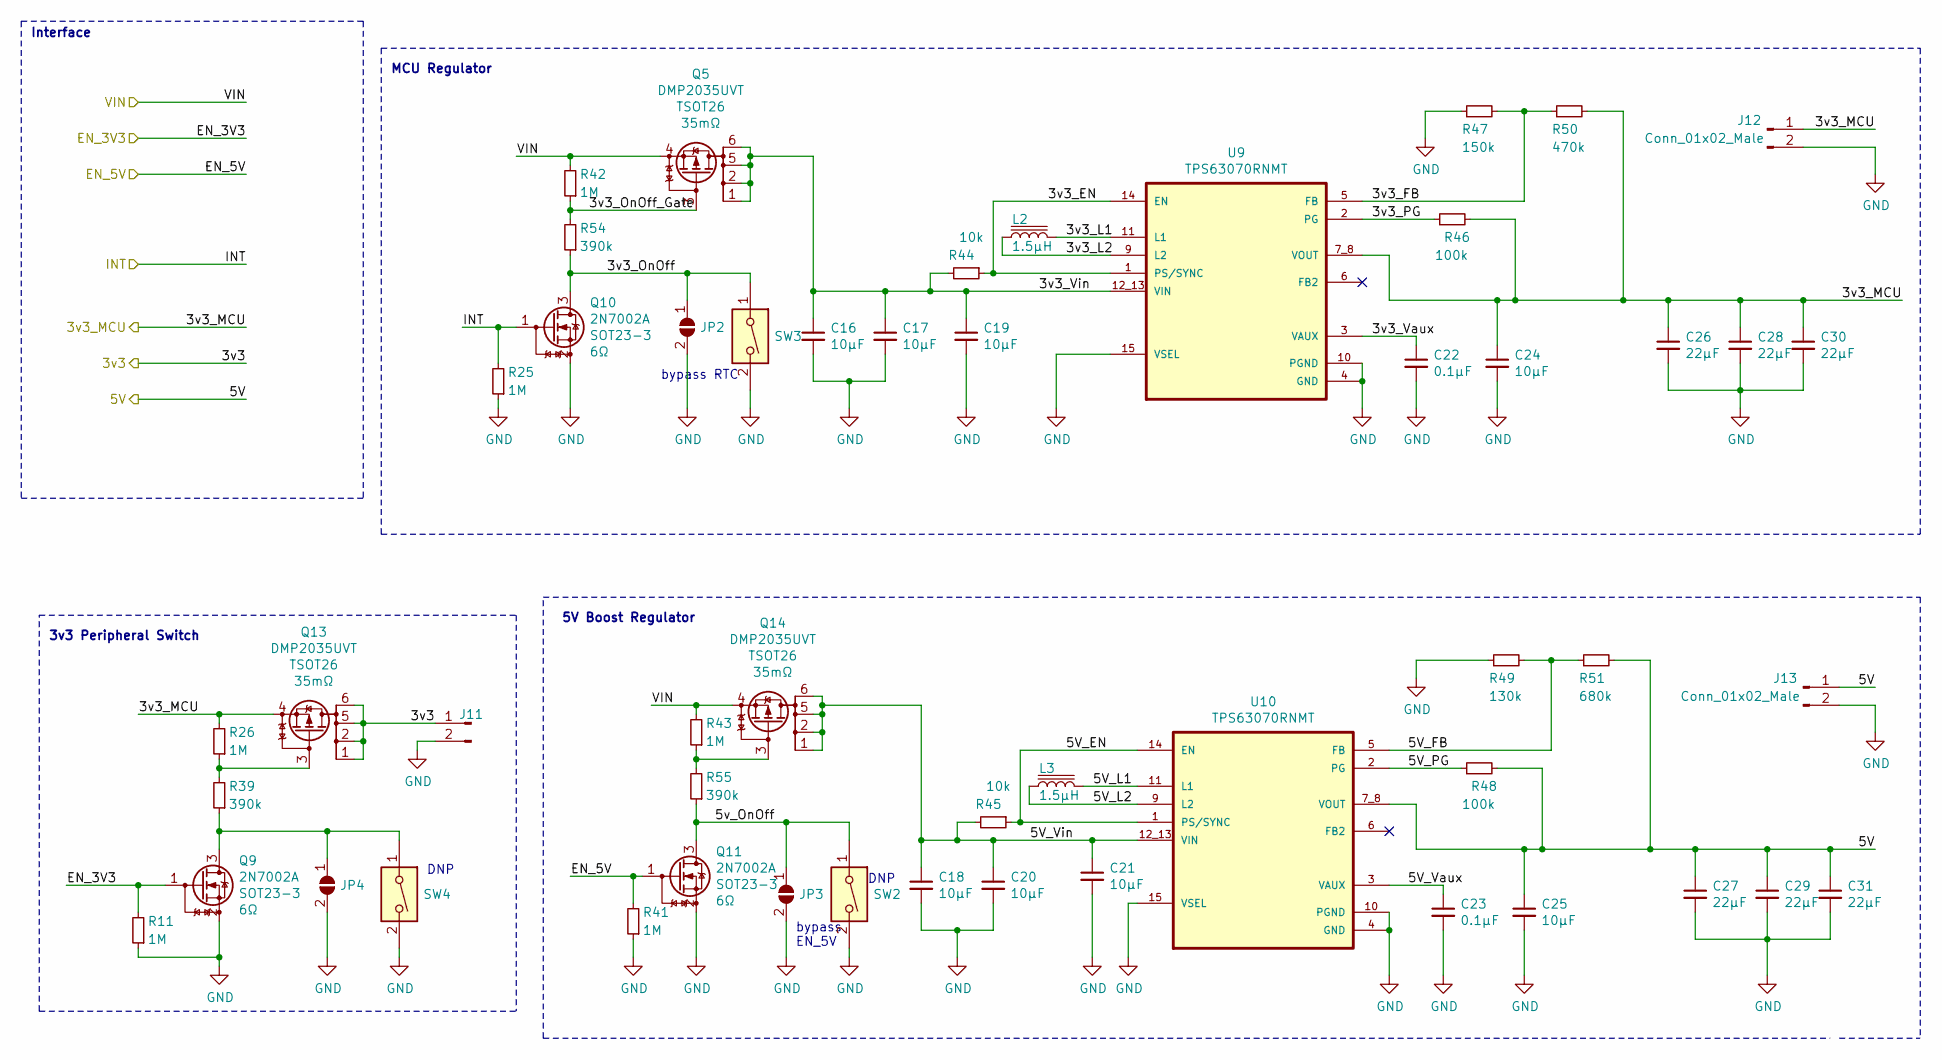
[picture p14: schematic regulator.sch, SuperPower-uC]

Parts:
C16, C17, C18, C19, C20, C21, C24, C25: 10μF; C_0805_2012Metric
C22, C23: 0.1µF; C_0603_1608Metric
C26, C27, C28, C29, C30, C31: 22μF; C_0805_2012Metric
J11, J12, J13: Conn_01x02_Male; PinSocket_1x02_P2.54mm_Vertical
JP2, JP3, JP4: SolderJumper_2_Open; SolderJumper-2_P1.3mm_Open_TrianglePad1.0x1.5mm
L2, L3: SPM6530T-1R5M; L_TDK_SPM6530T; Farnell_ref 2215610
Q5, Q13, Q14: DMP2035UVT; SOT-23-6; Farnell_ref 3405183
Q9, Q10, Q11: 2N7002A; SOT-23; Farnell_ref 3127180
R11, R25, R26, R41, R42, R43: 1M; R_0603_1608Metric
R39, R54, R55: 390k; R_0603_1608Metric
R44, R45: 10k; R_0603_1608Metric
R46, R48: 100k; R_0603_1608Metric
R47: 150k; R_0603_1608Metric
R49: 130k; R_0603_1608Metric
R50: 470k; R_0603_1608Metric
R51: 680k; R_0603_1608Metric
SW2, SW3, SW4: SW_DIP_x01; SW_DIP_SPSTx01_Slide_Copal_CHS-01A_W5.08mm_P1.27mm_JPin
U9, U10: TPS63070RNMT; VREG_TPS63070RNMR

Connections:
/MCU Module/3v3: J11.1, Q13.1 (D), Q13.2 (D), Q13.5 (D), Q13.6 (D); also elsewhere on the board
/MCU Module/3v3_MCU: C24.1, C26.1, C28.1, C30.1, J12.1, Q13.4 (S), R26.2, R46.2, R50.2, U9.7_8 (VOUT); also elsewhere on the board
/MCU Module/5V: C25.1, C27.1, C29.1, C31.1, J13.1, R48.2, R51.2, U10.7_8 (VOUT); also elsewhere on the board
/MCU Module/EN_3V3: Q9.1 (G), R11.2; also elsewhere on the board
/MCU Module/EN_5V: Q11.1 (G), R41.2; also elsewhere on the board
/RTC/INT: Q10.1 (G), R25.2; also elsewhere on the board
/Regulator and Cut-Off Module/3v3_EN: R44.1, U9.1 (PS/SYNC), U9.14 (EN)
/Regulator and Cut-Off Module/3v3_FB: R47.2, R50.1, U9.5 (FB)
/Regulator and Cut-Off Module/3v3_L1: L2.2, U9.11 (L1)
/Regulator and Cut-Off Module/3v3_L2: L2.1, U9.9 (L2)
/Regulator and Cut-Off Module/3v3_OnOff: JP2.1 (A), Q10.3 (D), R54.1, SW3.1
/Regulator and Cut-Off Module/3v3_OnOff_Gate: Q5.3 (G), R42.1, R54.2
/Regulator and Cut-Off Module/3v3_PG: R46.1, U9.2 (PG)
/Regulator and Cut-Off Module/3v3_Vaux: C22.1, U9.3 (VAUX)
/Regulator and Cut-Off Module/3v3_Vin: C16.1, C17.1, C19.1, Q5.1 (D), Q5.2 (D), Q5.5 (D), Q5.6 (D), R44.2, U9.12_13 (VIN)
/Regulator and Cut-Off Module/5V_EN: R45.1, U10.1 (PS/SYNC), U10.14 (EN)
/Regulator and Cut-Off Module/5V_FB: R49.2, R51.1, U10.5 (FB)
/Regulator and Cut-Off Module/5V_L1: L3.2, U10.11 (L1)
/Regulator and Cut-Off Module/5V_L2: L3.1, U10.9 (L2)
/Regulator and Cut-Off Module/5V_PG: R48.1, U10.2 (PG)
/Regulator and Cut-Off Module/5V_Vaux: C23.1, U10.3 (VAUX)
/Regulator and Cut-Off Module/5V_Vin: C18.1, C20.1, C21.1, Q14.1 (D), Q14.2 (D), Q14.5 (D), Q14.6 (D), R45.2, U10.12_13 (VIN)
/Regulator and Cut-Off Module/5v_OnOff: JP3.1 (A), Q11.3 (D), R55.1, SW2.1
/Regulator and Cut-Off Module/VIN: Q5.4 (S), Q14.4 (S), R42.2, R43.2; also elsewhere on the board
GND: C16.2, C17.2, C18.2, C19.2, C20.2, C21.2, C22.2, C23.2, C24.2, C25.2, C26.2, C27.2, C28.2, C29.2, C30.2, C31.2, J11.2, J12.2, J13.2, JP2.2 (B), JP3.2 (B), JP4.2 (B), Q9.2 (S), Q10.2 (S), Q11.2 (S), R11.1, R25.1, R41.1, R47.1, R49.1, SW2.2, SW3.2, SW4.2, U9.4 (GND), U9.10 (PGND), U9.15 (VSEL), U10.4 (GND), U10.10 (PGND), U10.15 (VSEL); also elsewhere on the board
unnamed: JP4.1 (A), Q9.3 (D), R39.1, SW4.1
unnamed: Q13.3 (G), R26.1, R39.2
unnamed: Q14.3 (G), R43.1, R55.2

Notes on the sheet:
Interface
5V Boost Regulator
bypass EN_5V
bypass RTC
MCU Regulator
3v3 Peripheral Switch
DNP
