Informaticore/SuperPower/SuperPower-uC/original/SuperPower-uC-KiCad.kicad_pcb

## KiCad design SuperPower-uC/original/SuperPower-uC-KiCad.kicad_pcb (continued)

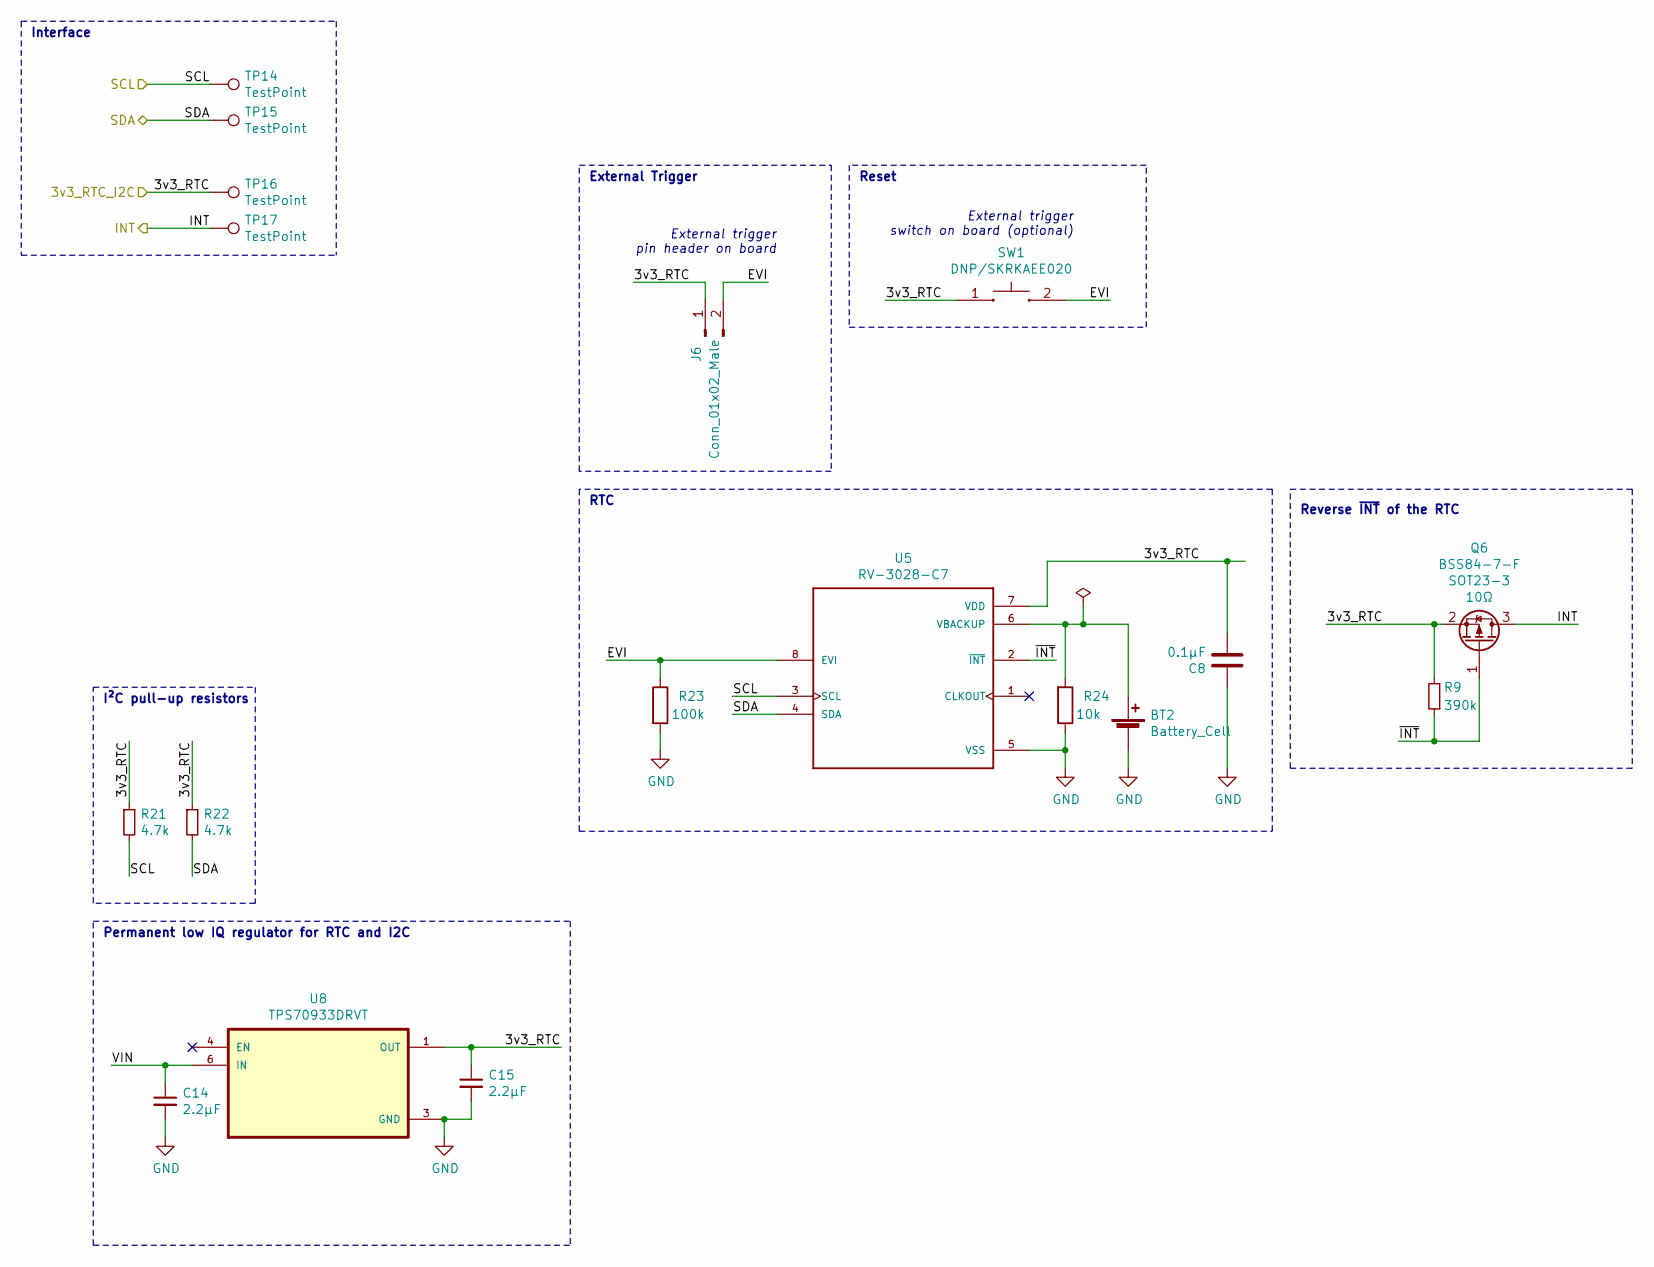
[picture p15: schematic rtc_cut_off.sch, SuperPower-uC]

Parts:
BT2: Battery_Cell; BatteryHolder_Keystone_3000_1x12mm
C8: 0.1µF; C_0603_1608Metric
C14, C15: 2.2μF; C_0603_1608Metric
J6: Conn_01x02_Male; PinHeader_1x02_P2.54mm_Vertical
Q6: BSS84-7-F; SOT-23; Farnell_ref 1843716
R9: 390k; R_0603_1608Metric
R21, R22: 4.7k; R_0603_1608Metric
R23: 100k; R_0603_1608Metric
R24: 10k; R_0603_1608Metric
SW1: DNP/SKRKAEE020; SKRKAEE020
TP14, TP15, TP16, TP17: TestPoint; TestPoint_Pad_D1.0mm
U5: RV-3028-C7; IC_RV-3028-C7
U8: TPS70933DRVT; SON65P200X200X80-7N

Connections:
/Charging Module/3v3_I2C: C8.2, C15.1, J6.1, Q6.2 (S), R9.2, R21.1, R22.1, SW1.1, TP16.1, U5.7 (VDD), U8.1 (OUT); also elsewhere on the board
/RTC/EVI: J6.2, R23.1, SW1.2, U5.8 (EVI)
/RTC/INT: Q6.3 (D), TP17.1; also elsewhere on the board
/RTC/VIN: C14.1, U8.6 (IN)
/RTC/~INT: Q6.1 (G), R9.1, U5.2 (~INT~)
/SCL: R21.2, TP14.1, U5.3 (SCL); also elsewhere on the board
/SDA: R22.2, TP15.1, U5.4 (SDA); also elsewhere on the board
GND: BT2.2 (-), C8.1, C14.2, C15.2, R23.2, R24.1, U5.5 (VSS), U8.3 (GND); also elsewhere on the board
unnamed: BT2.1 (+), R24.2, U5.6 (VBACKUP)

Notes on the sheet:
I²C pull-up resistors
External trigger pin header on board
Interface
External trigger switch on board (optional)
Permanent low IQ regulator for RTC and I2C
RTC
Reset
External Trigger
Reverse ~INT~ of the RTC

Board: 2 copper layers, 177 parts (7 on the bottom side), 114 nets, no tracks yet.
