Informaticore/SuperPower/(commit log)

2020-12-22 Update Placement + Increase MTG Hole Size
    [SuperPower-uC-KiCad.kicad_pcb, charger_io.sch]
2020-12-22 Shrink board height + Add Coin cell holder
    [SuperPower-uC-KiCad.kicad_pcb, rtc_cut_off.sch]
2020-12-22 Convert 3D Board into Step + Draw a simple Box
    [3D_Box.FCStd, 3D_Box_save_01.FCStd, 3D_Box_save_02.FCStd, SuperPower-uC-KiCad.kicad_pcb]
2020-12-23 Make all connectors on only 2 sides.
    + Move DC Jack Connector to avoid having pads in conflict with the battery holder body.
    [SuperPower-uC-KiCad.kicad_pcb]
2020-12-23 Update USB-C 3D footprint link
    [SuperPower-uC-KiCad.kicad_pcb]
2020-12-23 Update DC Power Jack connector
    Add 3D Model
    [694106301002 (rev1).step, SuperPower-uC-KiCad.kicad_pcb, charger_io.sch]
2020-12-23 Add JST ZH 3D Model
    [S2B-ZR.STEP, SuperPower-uC-KiCad.kicad_pcb, charger.sch]
2020-12-23 Update 3D Board + Case
    [3D_Box.FCStd, 3D_Box_save_03.FCStd, 3D_Box_save_04.FCStd]
2020-12-23 Update DMP3028LSD SO-8 3D Package
    [SuperPower-uC-KiCad.kicad_pcb, charger_io.sch]
2020-12-23 Update DMN3018SSD SO-8 3D Package
    [SuperPower-uC-KiCad.kicad_pcb, charger.sch]
2020-12-24 Update 18650 Battery Holder 3D Model
    + Board 3D Model + 3D box
    [3D_Box.FCStd, 3D_Box_save_05.FCStd, SuperPower-uC-KiCad.kicad_pcb, battery_protection.sch, keystone-PN1042.STEP]
2020-12-24 Add a second optional Schottky diode for High Current
    [SuperPower-uC-KiCad.kicad_pcb, charger_io.sch]
2020-12-26 Update components Placement
    RTC + 3.3 LDO + single raw connectors (x2)
    [SuperPower-uC-KiCad.kicad_pcb]
2020-12-26 Update SKRKAEE020 tactile switch 3D footprint
    [SuperPower-uC-KiCad.kicad_pcb]
2020-12-26 Update RV-3028-C7 3D Footprint
    [RV-3028-C7_MWNN.step, SuperPower-uC-KiCad.kicad_pcb]
2020-12-26 Update TPS709xx series 3D footprint
    [SuperPower-uC-KiCad.kicad_pcb]
2020-12-26 Update Single rows Headers to be fully compatible with ESP WROOM modules
    (ESP-32 DevKit C rev. 4)
    [SuperPower-uC-KiCad.kicad_pcb, mcu.sch, regulator.sch, rtc_cut_off.sch]
2020-12-26 Update Placement + Add some labels
    +3.3V Buck-Boost DC-DC converter
    [SuperPower-uC-KiCad.kicad_pcb, regulator.sch]
2020-12-27 Update Placement USB_UART_Bridge
    + Misc.
    [SuperPower-uC-KiCad.kicad_pcb, battery_protection.sch, charger_io.sch, mcu.sch]
2020-12-27 Update LTC4162-L components placement
    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
    [SuperPower-uC-KiCad.kicad_pcb, charger.sch]
2020-12-27 Update components Placement
    +5V Buck-Boost + Misc.
    [SuperPower-uC-KiCad.kicad_pcb, regulator.sch]
2020-12-29 Add some DIP switch 1 way (x3)
    + add optionnal on board 0603 NTC + misc.
    [SuperPower-uC-KiCad.kicad_pcb, charger.sch, regulator.sch]
2020-12-30 Update 3D Board + Box
    [3D_Box.FCStd, 3D_Box_save_06.FCStd, 3D_Box_save_07.FCStd]
