Informaticore/SuperPower/(notices)

Notices in the files:
SuperPower-uC/original/charger.sch:
Licence: CERN-OHL-W
